Olivermoberg98/LED-Coaster/Software/LED_coaster/tools/rundown/runs/2026-10-10.png

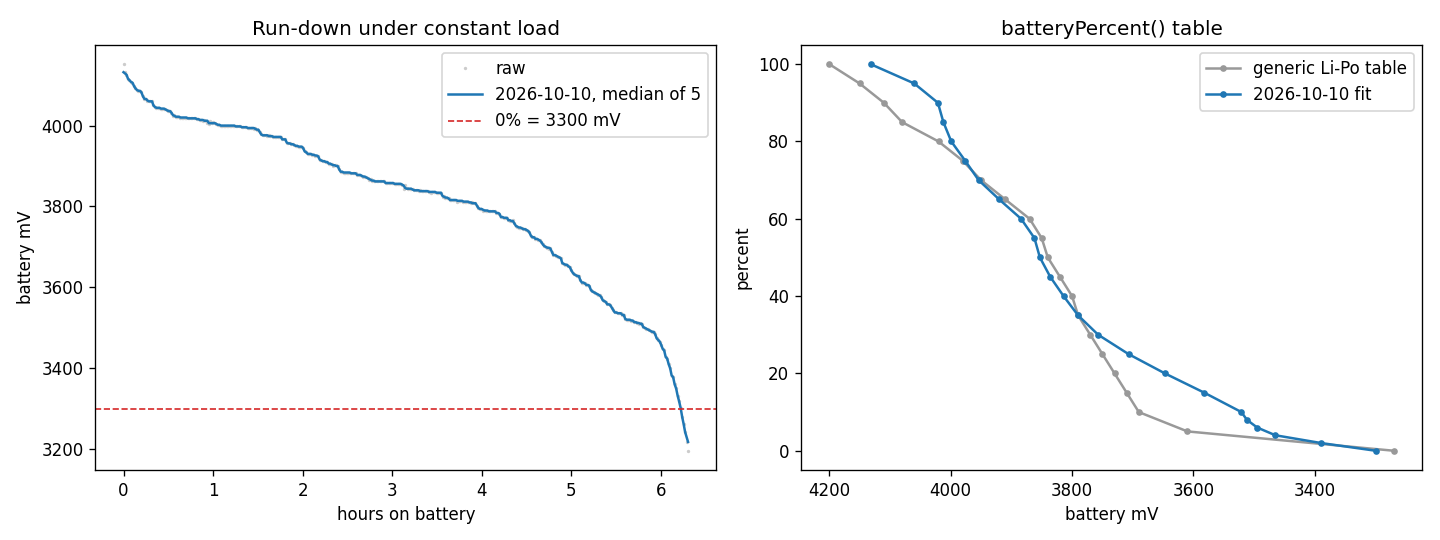
Software/LED_coaster/tools/rundown/runs/2026-10-10.png
