Olivermoberg98/LED-Coaster/Hardware/3d_printing/LED_Coaster_bottom.3mf

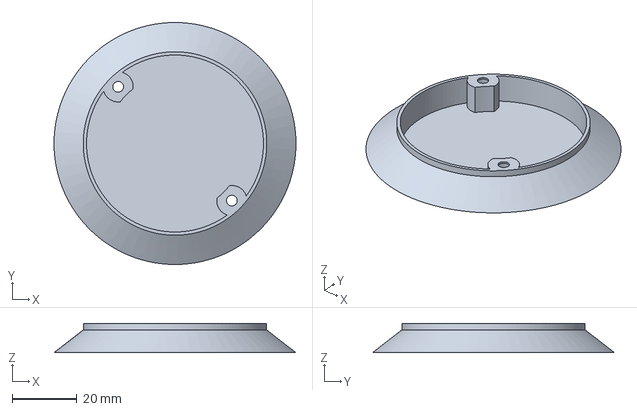
[picture p2: CAD file, 2026-10-16]
Hardware/3d_printing/LED_Coaster_bottom.3mf
74.6 x 74.5 x 9.00 mm
