Olivermoberg98/LED-Coaster/Hardware/3d_printing/LED_Coaster.step

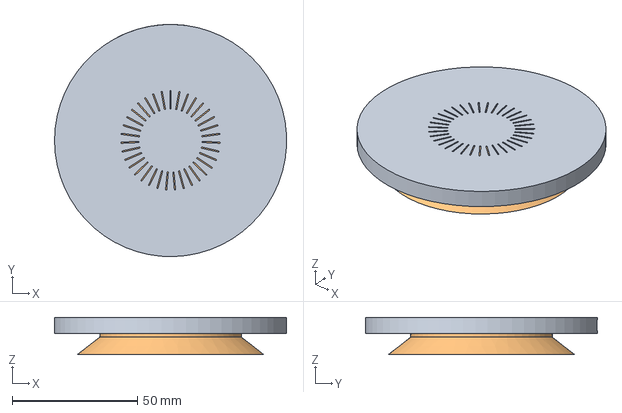
[picture p3: CAD file, 2026-10-16]
Hardware/3d_printing/LED_Coaster.step
92.5 x 92.6 x 14.9 mm
