Olivermoberg98/LED-Coaster/Hardware/3d_printing/LED_Coaster_top.3mf

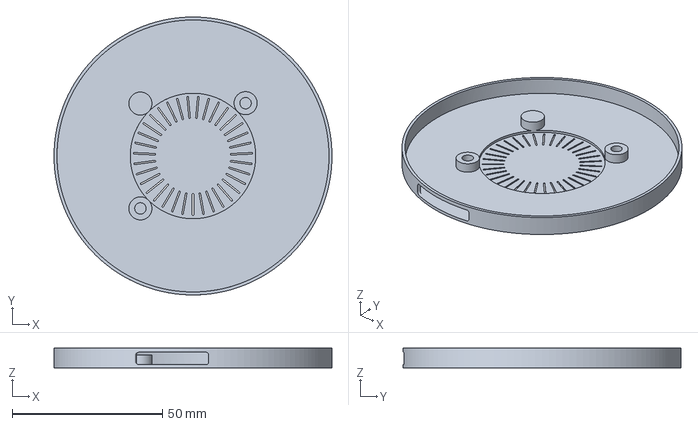
[picture p4: CAD file, 2026-10-16]
Hardware/3d_printing/LED_Coaster_top.3mf
92.6 x 92.6 x 6.50 mm
