Olivermoberg98/LED-Coaster/(list of files, cad)

Other CAD files:
Hardware/3d_printing/LED_Coaster_bottom.stl
Hardware/3d_printing/LED_Coaster_top.stl
