Olivermoberg98/LED-Coaster/Hardware/PCB/LED_Coaster.kicad_pcb

## KiCad design Hardware/PCB/LED_Coaster.kicad_pcb (2026-09-19)

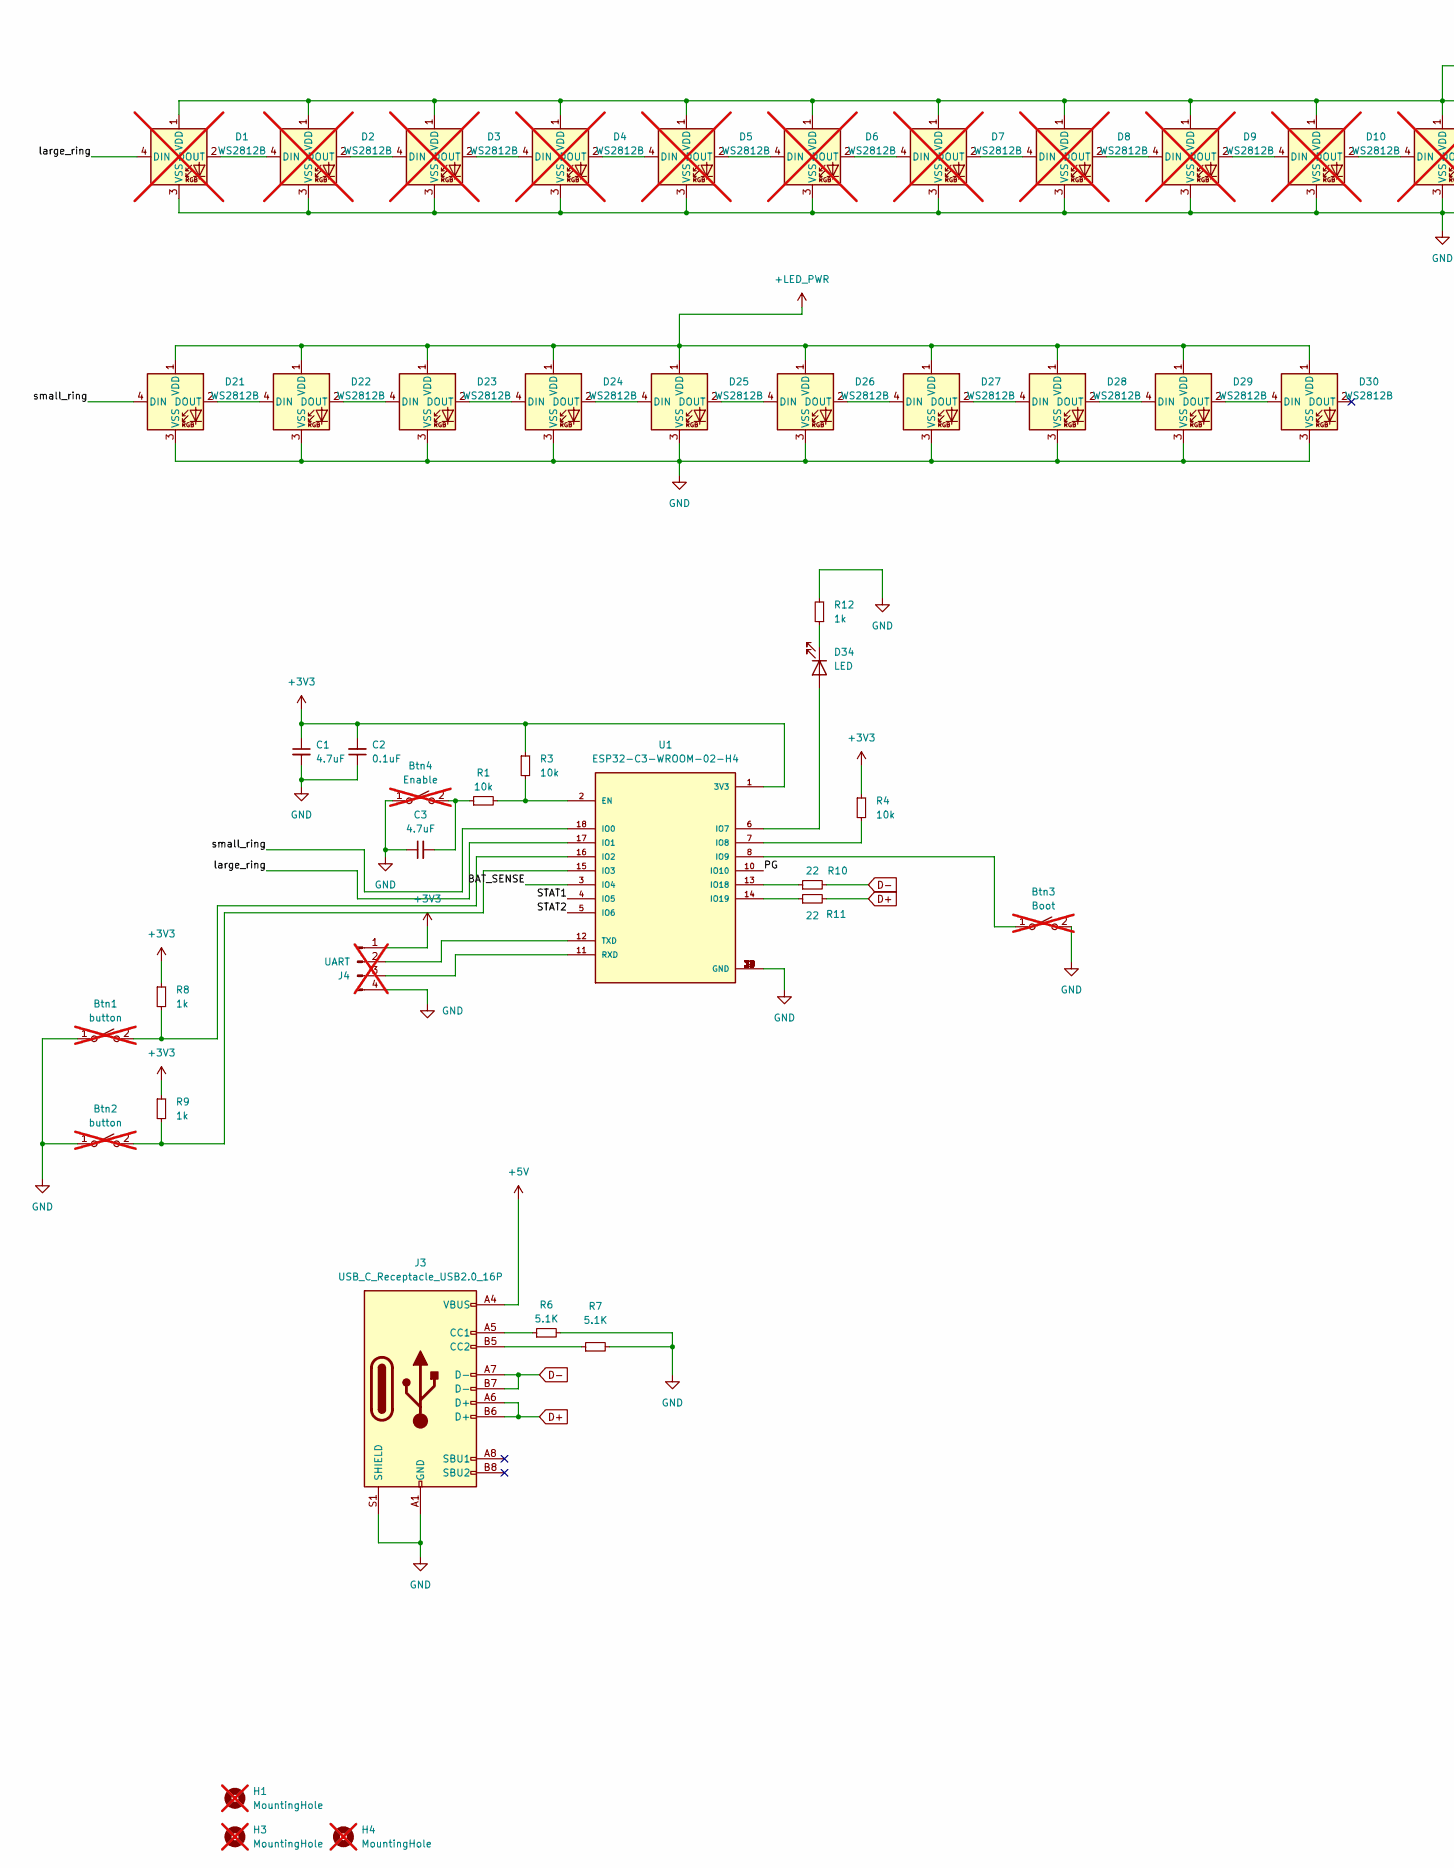
[picture p5: schematic LED_Coaster.kicad_sch, part in row 1, column 1]

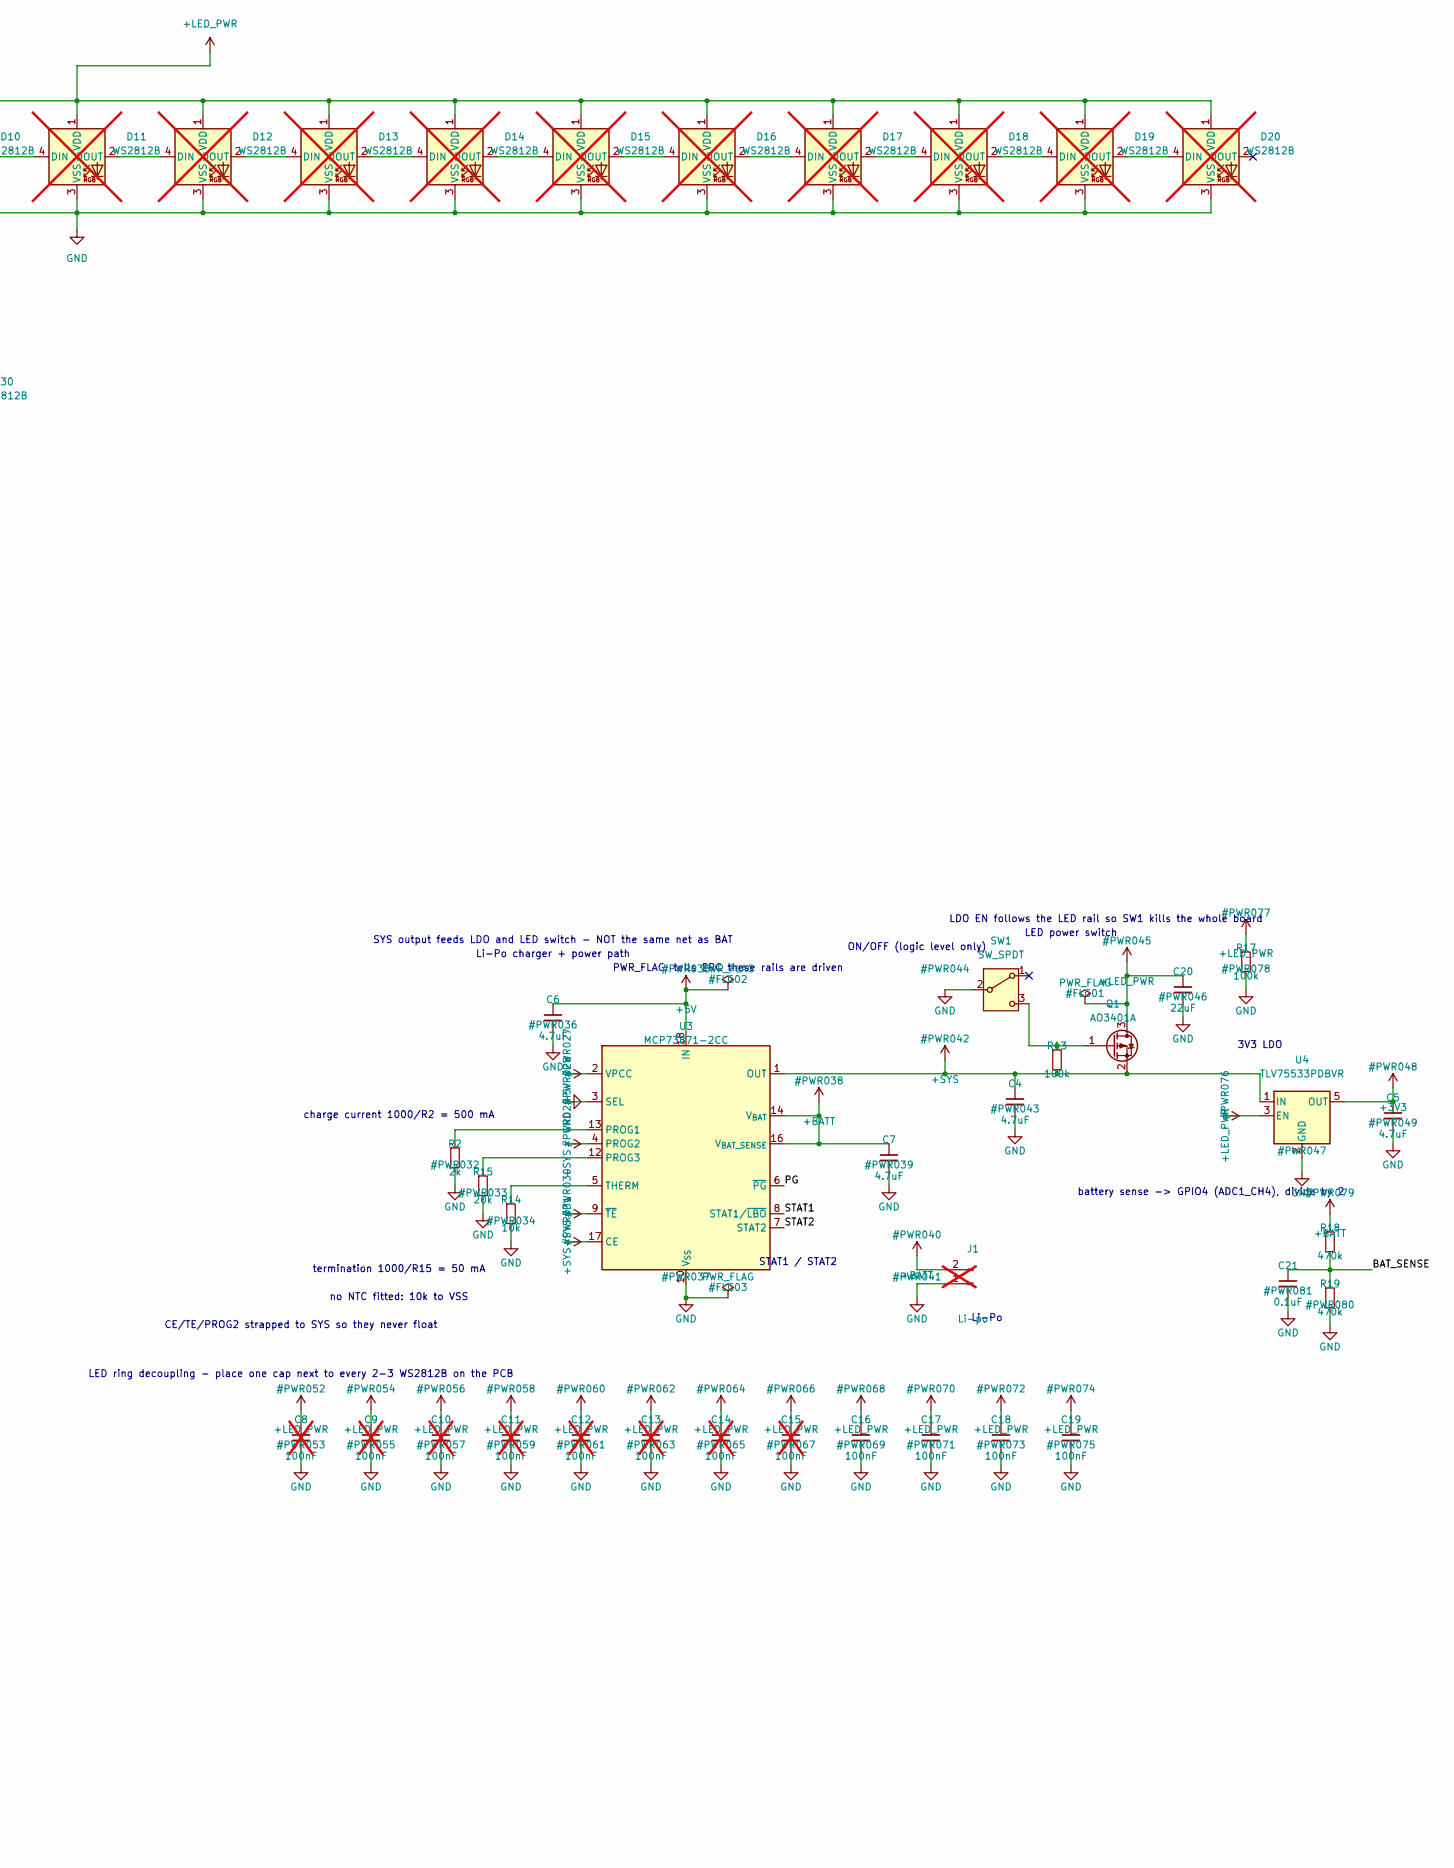
[picture p6: schematic LED_Coaster.kicad_sch, part in row 1, column 2]

Parts:
Btn1, Btn2: button; SW_SPST_SKQG_WithStem; MPN C318884; not fitted
Btn3: Boot; SW_SPST_SKQG_WithStem; MPN C318884; not fitted
Btn4: Enable; SW_SPST_SKQG_WithStem; MPN C318884; not fitted
C1, C3, C4, C5, C6, C7: 4.7uF; C_0805_2012Metric_Pad1.18x1.45mm_HandSolder; MPN C1779
C2, C21: 0.1uF; C_0805_2012Metric_Pad1.18x1.45mm_HandSolder; MPN C28233
C8, C9, C10, C11, C12, C13, C14, C15: 100nF; C_0603_1608Metric_Pad1.08x0.95mm_HandSolder; MPN C14663; not fitted
C16, C17, C18, C19: 100nF; C_0603_1608Metric_Pad1.08x0.95mm_HandSolder; MPN C14663
C20: 22uF; C_0805_2012Metric_Pad1.18x1.45mm_HandSolder; MPN C380336
D1, D2, D3, D4, D5, D6, D7, D8, D9, D10, D11, D12, D13, D14, D15, D16, D17, D18, D19, D20: WS2812B; LED_WS2812_5050_handsolder; MPN C26167850; not fitted
D21, D22, D23, D24, D25, D26, D27, D28, D29, D30: WS2812B; LED_WS2812_5050_handsolder; MPN C26167850
D34: LED; LED_0805_2012Metric_Pad1.15x1.40mm_HandSolder; MPN C2297
H1, H3, H4: MountingHole; MountingHole_4.3mm_M4_Pad_Via; not fitted
J1: Li-po; JST_EH_S2B-EH_1x02_P2.50mm_Horizontal; not fitted
J3: USB_C_Receptacle_USB2.0_16P; USB_C_Receptacle_HRO_TYPE-C-31-M-12; MPN C165948
J4: UART; PinHeader_1x04_P2.54mm_Vertical; not fitted
Q1: AO3401A; SOT-23; MPN C15127
R1, R3, R4, R14: 10k; R_0805_2012Metric_Pad1.20x1.40mm_HandSolder; MPN C17414
R2: 2k; R_0805_2012Metric_Pad1.20x1.40mm_HandSolder; MPN C17604
R6, R7: 5.1K; R_0805_2012Metric_Pad1.20x1.40mm_HandSolder; MPN C27834
R8, R9, R12: 1k; R_0805_2012Metric_Pad1.20x1.40mm_HandSolder; MPN C17513
R10, R11: 22; R_0805_2012Metric_Pad1.20x1.40mm_HandSolder; MPN C17561
R13, R17: 100k; R_0805_2012Metric_Pad1.20x1.40mm_HandSolder; MPN C149504
R15: 20k; R_0805_2012Metric_Pad1.20x1.40mm_HandSolder; MPN C4328
R18, R19: 470k; R_0805_2012Metric_Pad1.20x1.40mm_HandSolder; MPN C17709
SW1: SW_SPDT; SW_SPDT_CK_JS102011SAQN; MPN C221660
U1: ESP32-C3-WROOM-02-H4; MODULE_ESP32-C3-WROOM-02-H4; MPN C2944070
U3: MCP73871-2CC; QFN-20-1EP_4x4mm_P0.5mm_EP2.5x2.5mm_ThermalVias; MPN C5121473
U4: TLV75533PDBVR; SOT-23-5; MPN C404027

Connections:
+3V3: C1.1, C2.2, C5.1, J4.1, R3.1, R4.1, R8.1, R9.1, U1.1 (3V3), U4.5 (OUT)
+5V: C6.1, J3.A4 (VBUS), J3.A9 (VBUS), J3.B4 (VBUS), J3.B9 (VBUS), U3.2 (VPCC), U3.18 (IN), U3.19 (IN)
+BATT: C7.1, J1.2, R18.1, U3.14 (V_{BAT}), U3.15 (V_{BAT}), U3.16 (V_{BAT_SENSE})
+LED_PWR: C8.1, C9.1, C10.1, C11.1, C12.1, C13.1, C14.1, C15.1, C16.1, C17.1, C18.1, C19.1, C20.1, D1.1 (VDD), D2.1 (VDD), D3.1 (VDD), D4.1 (VDD), D5.1 (VDD), D6.1 (VDD), D7.1 (VDD), D8.1 (VDD), D9.1 (VDD), D10.1 (VDD), D11.1 (VDD), D12.1 (VDD), D13.1 (VDD), D14.1 (VDD), D15.1 (VDD), D16.1 (VDD), D17.1 (VDD), D18.1 (VDD), D19.1 (VDD), D20.1 (VDD), D21.1 (VDD), D22.1 (VDD), D23.1 (VDD), D24.1 (VDD), D25.1 (VDD), D26.1 (VDD), D27.1 (VDD), D28.1 (VDD), D29.1 (VDD), D30.1 (VDD), Q1.3 (D), R17.1, U4.3 (EN)
+SYS: C4.1, Q1.2 (S), R13.2, U3.1 (OUT), U3.4 (PROG2), U3.9 (~TE), U3.17 (CE), U3.20 (OUT), U4.1 (IN)
/BAT_SENSE: C21.1, R18.2, R19.1, U1.3 (IO4)
/PG: U1.10 (IO10), U3.6 (~PG)
/STAT1: U1.4 (IO5), U3.8 (STAT1/~LBO)
/STAT2: U1.5 (IO6), U3.7 (STAT2)
/large_ring: D1.4 (DIN), U1.17 (IO1)
/small_ring: D21.4 (DIN), U1.18 (IO0)
D+: J3.A6 (D+), J3.B6 (D+), R11.2
D-: J3.A7 (D-), J3.B7 (D-), R10.2
GND: Btn1.1 (A), Btn2.1 (A), Btn3.2 (B), Btn4.1 (A), C1.2, C2.1, C3.1, C4.2, C5.2, C6.2, C7.2, C8.2, C9.2, C10.2, C11.2, C12.2, C13.2, C14.2, C15.2, C16.2, C17.2, C18.2, C19.2, C20.2, C21.2, D1.3 (VSS), D2.3 (VSS), D3.3 (VSS), D4.3 (VSS), D5.3 (VSS), D6.3 (VSS), D7.3 (VSS), D8.3 (VSS), D9.3 (VSS), D10.3 (VSS), D11.3 (VSS), D12.3 (VSS), D13.3 (VSS), D14.3 (VSS), D15.3 (VSS), D16.3 (VSS), D17.3 (VSS), D18.3 (VSS), D19.3 (VSS), D20.3 (VSS), D21.3 (VSS), D22.3 (VSS), D23.3 (VSS), D24.3 (VSS), D25.3 (VSS), D26.3 (VSS), D27.3 (VSS), D28.3 (VSS), D29.3 (VSS), D30.3 (VSS), J1.1, J3.A1 (GND), J3.A12 (GND), J3.B1 (GND), J3.B12 (GND), J3.S1 (SHIELD), J4.4, R2.2, R6.2, R7.2, R12.2, R14.2, R15.2, R17.2, R19.2, SW1.2 (B), U1.9 (GND), U1.19 (GND), U1.20 (GND), U1.21 (GND), U1.22 (GND), U1.23 (GND), U1.24 (GND), U1.25 (GND), U1.26 (GND), U1.27 (GND), U1.28 (GND), U1.29 (GND), U1.30 (GND), U1.31 (GND), U1.32 (GND), U1.33 (GND), U1.34 (GND), U1.35 (GND), U1.36 (GND), U1.37 (GND), U1.38 (GND), U1.39 (GND), U3.3 (SEL), U3.10 (V_{SS}), U3.11 (V_{SS}), U3.21 (V_{SS}), U4.2 (GND)
unnamed: Btn1.2 (B), R8.2, U1.16 (IO2)
unnamed: Btn2.2 (B), R9.2, U1.15 (IO3)
unnamed: Btn3.1 (A), U1.8 (IO9)
unnamed: Btn4.2 (B), C3.2, R1.1
unnamed: D1.2 (DOUT), D2.4 (DIN)
unnamed: D2.2 (DOUT), D3.4 (DIN)
unnamed: D3.2 (DOUT), D4.4 (DIN)
unnamed: D4.2 (DOUT), D5.4 (DIN)
unnamed: D5.2 (DOUT), D6.4 (DIN)
unnamed: D6.2 (DOUT), D7.4 (DIN)
unnamed: D7.2 (DOUT), D8.4 (DIN)
unnamed: D8.2 (DOUT), D9.4 (DIN)
unnamed: D9.2 (DOUT), D10.4 (DIN)
unnamed: D10.2 (DOUT), D11.4 (DIN)
unnamed: D11.2 (DOUT), D12.4 (DIN)
unnamed: D12.2 (DOUT), D13.4 (DIN)
unnamed: D13.2 (DOUT), D14.4 (DIN)
unnamed: D14.2 (DOUT), D15.4 (DIN)
unnamed: D15.2 (DOUT), D16.4 (DIN)
unnamed: D16.2 (DOUT), D17.4 (DIN)
unnamed: D17.2 (DOUT), D18.4 (DIN)
unnamed: D18.2 (DOUT), D19.4 (DIN)
unnamed: D19.2 (DOUT), D20.4 (DIN)
unnamed: D21.2 (DOUT), D22.4 (DIN)
unnamed: D22.2 (DOUT), D23.4 (DIN)
unnamed: D23.2 (DOUT), D24.4 (DIN)
unnamed: D24.2 (DOUT), D25.4 (DIN)
unnamed: D25.2 (DOUT), D26.4 (DIN)
unnamed: D26.2 (DOUT), D27.4 (DIN)
unnamed: D27.2 (DOUT), D28.4 (DIN)
unnamed: D28.2 (DOUT), D29.4 (DIN)
unnamed: D29.2 (DOUT), D30.4 (DIN)
unnamed: D34.2 (A), U1.6 (IO7)
unnamed: D34.1 (K), R12.1
unnamed: J3.A5 (CC1), R6.1
unnamed: J3.B5 (CC2), R7.1
unnamed: J4.2, U1.12 (TXD)
unnamed: J4.3, U1.11 (RXD)
unnamed: Q1.1 (G), R13.1, SW1.3 (C)
unnamed: R1.2, R3.2, U1.2 (EN)
unnamed: R4.2, U1.7 (IO8)
unnamed: R10.1, U1.13 (IO18)
unnamed: R11.1, U1.14 (IO19)
unnamed: R2.1, U3.13 (PROG1)
unnamed: R15.1, U3.12 (PROG3)
unnamed: R14.1, U3.5 (THERM)

Notes on the sheet:
Li-Po charger + power path
SYS output feeds LDO and LED switch - NOT the same net as BAT
charge current 1000/R2 = 500 mA
termination 1000/R15 = 50 mA
no NTC fitted: 10k to VSS
CE/TE/PROG2 strapped to SYS so they never float
ON/OFF (logic level only)
LED power switch
3V3 LDO
Li-Po
STAT1 / STAT2
LED ring decoupling - place one cap next to every 2-3 WS2812B on the PCB
LDO EN follows the LED rail so SW1 kills the whole board
battery sense -> GPIO4 (ADC1_CH4), divide by 2
PWR_FLAG: tells ERC these rails are driven

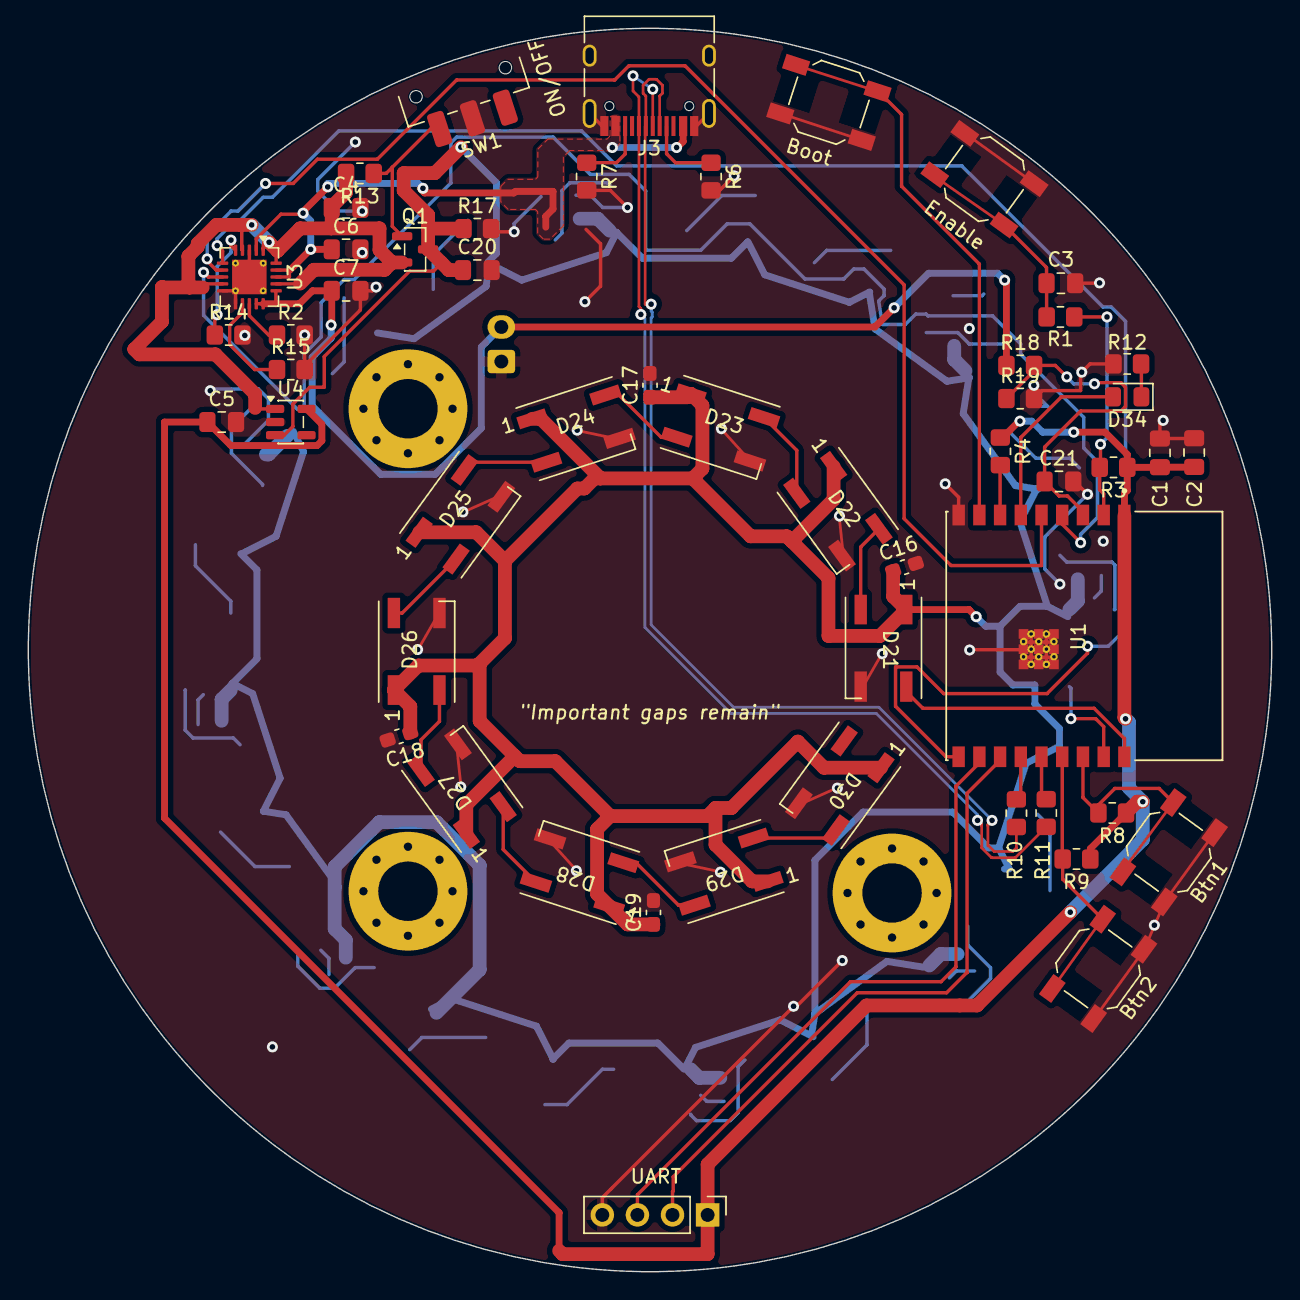
[picture p7: board LED_Coaster.kicad_pcb from above]

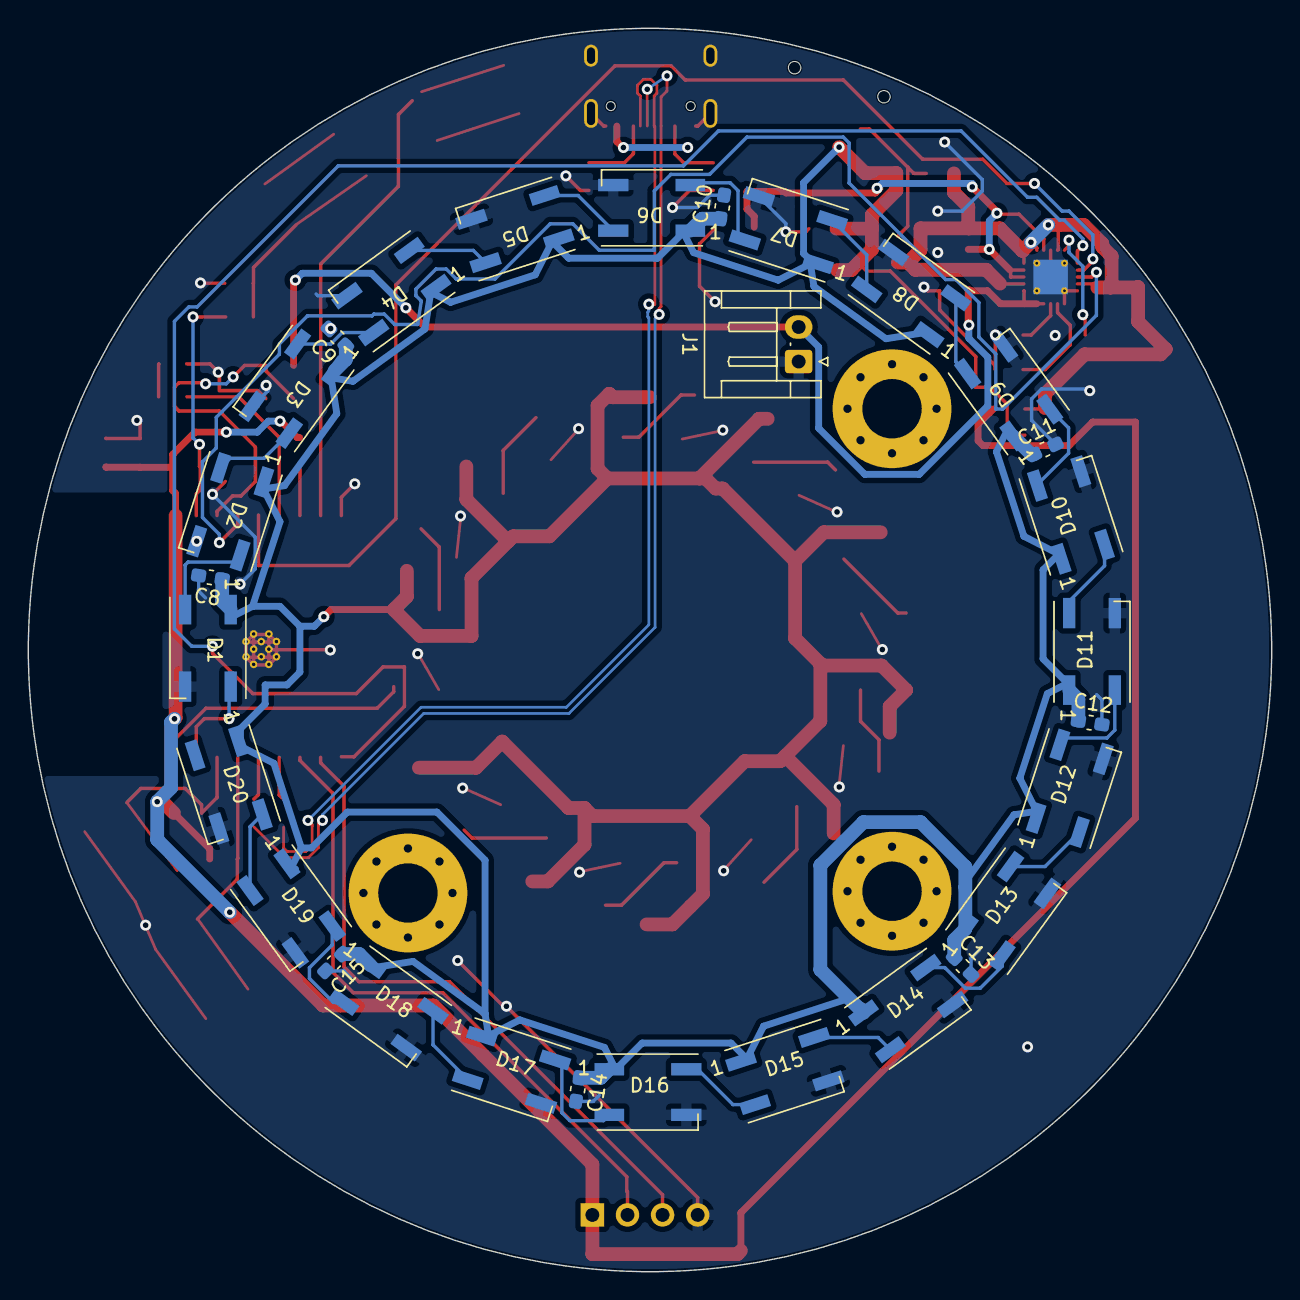
[picture p8: board LED_Coaster.kicad_pcb from below]

Board: 2 copper layers, 90.0 x 90.0 mm, 84 parts (29 on the bottom side), 60 nets.
