Olivermoberg98/LED-Coaster/Software/LED_coaster/src/main.cpp

#include <Arduino.h>
#include <FastLED.h>
#include <patterns.h>
#include <BLEHandler.h>
#ifdef RUNDOWN_LOG
#include <LittleFS.h>
#endif

CRGB led_output_inner[NUM_LEDS_INNER]; 
CRGB led_output_outer[NUM_LEDS_OUTER]; 

PatternType inner_pattern = FIXED;
PatternType outer_pattern = FIXED;

std::string coasterID = "05"; // Unique per coaster: advertised as "Coaster-<id>"
BLEHandler blehandler(coasterID);

// Battery sense: +BATT through a 470k/470k divider, so the pin sees half the cell.
const int BAT_SENSE_PIN = 4;
// MCP73871 status outputs, all open-drain (High-Z reads HIGH with the pull-ups).
const int STAT1_PIN = 5;
const int STAT2_PIN = 6;
const int PG_PIN = 10;
// D34, through R12 (1k) to GND: the board's only charge indicator.
const int CHARGE_LED_PIN = 7;
const unsigned long BATTERY_REPORT_INTERVAL_MS = 2000;
unsigned long lastBatteryReport = 0;
const unsigned long STATUS_PUSH_INTERVAL_MS = 30000;
unsigned long lastStatusPush = 0;
// Below this the low-battery flag is set even before the charger raises LBO (3.1 V).
// About 15% on the fitted curve, roughly 55 minutes left at a ~150 mA load.
const uint32_t LOW_BATTERY_WARN_MV = 3580;
// Below this on battery for three readings in a row, the coaster turns its LEDs off
// and deep-sleeps (0% on the fitted curve). SW1 off/on wakes it.
const uint32_t CUTOFF_MV = 3300;
int cutoffLowReadings = 0;
// While charging, the ~420 mA charge current through the ~0.24 Ohm path to the cell
// lifts the reading about this far above the discharge curve.
const uint32_t CHARGING_OFFSET_MV = 100;
// LED current cap: the full cap down to 3.60 V, where it still holds +SYS at 3.40 V,
// then falling linearly to the minimum at 3.40 V as the cell's sag grows.
const uint32_t LED_CAP_FULL_MV = 3600;
const uint32_t LED_CAP_MIN_MV = 3400;
const uint32_t LED_CAP_FULL_MA = 900;
const uint32_t LED_CAP_MIN_MA = 300;
// The cap changes only after the reading moves this far, so brightness doesn't step visibly.
const uint32_t LED_CAP_HYSTERESIS_MV = 50;
uint32_t ledCapMilliamps = LED_CAP_FULL_MA;
uint32_t ledCapMillivolts = 0;

// Charger state as carried in Package 3; values are part of the BLE contract.
enum ChargerState : uint8_t {
  CHARGER_UNKNOWN = 0,
  CHARGER_ON_BATTERY = 1,
  CHARGER_CHARGING = 2,
  CHARGER_COMPLETE = 3,
  CHARGER_LOW_BATTERY = 4,
  CHARGER_TEMP_FAULT = 5,
  CHARGER_NO_BATTERY = 6
};
// Reported state only changes once a new reading has held for two reads in a row.
ChargerState reportedChargerState = CHARGER_UNKNOWN;
ChargerState pendingChargerState = CHARGER_UNKNOWN;

// Averages several calibrated readings; the LED rail is noisy while patterns run.
uint32_t readBatteryMillivolts() {
  const int samples = 16;
  uint32_t sum = 0;
  for (int i = 0; i < samples; i++) {
    sum += analogReadMilliVolts(BAT_SENSE_PIN);
  }
  return (sum / samples) * 2;
}

// Discharge curve of the 1500 mAh cell, fitted from the 2026-10-10 run-down at a
// constant ~150 mA load, linearly interpolated between points. 0% sits at 3.30 V.
int batteryPercent(uint32_t mv) {
  static const uint16_t curve[][2] = {
    {4132, 100}, {4060, 95}, {4021, 90}, {4012, 85}, {3999, 80}, {3976, 75},
    {3954, 70},  {3920, 65}, {3884, 60}, {3862, 55}, {3853, 50}, {3836, 45},
    {3814, 40},  {3790, 35}, {3757, 30}, {3707, 25}, {3647, 20}, {3582, 15},
    {3521, 10},  {3512, 8},  {3495, 6},  {3465, 4},  {3390, 2},  {3300, 0}
  };
  const int points = sizeof(curve) / sizeof(curve[0]);
  if (mv >= curve[0][0]) return 100;
  if (mv <= curve[points - 1][0]) return 0;
  for (int i = 1; i < points; i++) {
    if (mv >= curve[i][0]) {
      uint32_t vHigh = curve[i - 1][0], vLow = curve[i][0];
      uint32_t pHigh = curve[i - 1][1], pLow = curve[i][1];
      return pLow + (mv - vLow) * (pHigh - pLow) / (vHigh - vLow);
    }
  }
  return 0;
}

// Decodes the status outputs per MCP73871 datasheet Table 5-1.
ChargerState chargerState() {
  bool pg = digitalRead(PG_PIN);
  bool stat1 = digitalRead(STAT1_PIN);
  bool stat2 = digitalRead(STAT2_PIN);
  if (!pg && !stat1 && stat2)  return CHARGER_CHARGING;
  if (!pg && stat1 && !stat2)  return CHARGER_COMPLETE;
  if (!pg && !stat1 && !stat2) return CHARGER_TEMP_FAULT;
  if (!pg && stat1 && stat2)   return CHARGER_NO_BATTERY;
  if (pg && !stat1 && stat2)   return CHARGER_LOW_BATTERY;
  if (pg && stat1 && stat2)    return CHARGER_ON_BATTERY;
  return CHARGER_UNKNOWN;
}

const char* chargerStateName(ChargerState state) {
  switch (state) {
    case CHARGER_ON_BATTERY:  return "on battery";
    case CHARGER_CHARGING:    return "charging";
    case CHARGER_COMPLETE:    return "charge complete";
    case CHARGER_LOW_BATTERY: return "low battery";
    case CHARGER_TEMP_FAULT:  return "temperature fault";
    case CHARGER_NO_BATTERY:  return "no battery present";
    default:                  return "unknown";
  }
}

#ifdef RUNDOWN_LOG
// Run-down log: one sample per minute while on battery, appended to flash so it
// survives the end of the run. Read back over USB serial with "dump", wiped with "clear".
const char* RUNDOWN_FILE = "/rundown.bin";
const unsigned long RUNDOWN_SAMPLE_INTERVAL_MS = 60000;
// The run ends below this, before the cell's own protection trips.
const uint32_t RUNDOWN_CUTOFF_MV = 3200;
const uint8_t RUNDOWN_CUTOFF_FLAG = 0x80;
// Constant inner-ring load of about 120 mA, so a 1500 mAh cell runs down overnight.
const CRGB RUNDOWN_LOAD_COLOR = CRGB(85, 85, 85);
unsigned long lastRundownSample = 0;
bool rundownSampled = false;
int rundownLowReadings = 0;

struct __attribute__((packed)) RundownSample {
  uint32_t uptime;
  uint16_t mv;
  uint8_t chargerState;
  uint8_t flags;
};

void appendRundownSample(uint32_t mv, uint8_t state, uint8_t flags) {
  RundownSample sample = {millis() / 1000, (uint16_t)mv, state, flags};
  File file = LittleFS.open(RUNDOWN_FILE, FILE_APPEND);
  if (file) {
    file.write((const uint8_t*)&sample, sizeof(sample));
    file.close();
  }
}

// Called on every battery reading. Samples once a minute while on battery, and at
// the cut-off writes a final flagged sample, turns the LEDs off and deep-sleeps.
void rundownReading(uint32_t mv, uint8_t state, uint8_t flags, bool usbPower) {
  if (usbPower) {
    rundownLowReadings = 0;
    return;
  }
  rundownLowReadings = (mv < RUNDOWN_CUTOFF_MV) ? rundownLowReadings + 1 : 0;
  if (rundownLowReadings >= 3) {
    appendRundownSample(mv, state, flags | RUNDOWN_CUTOFF_FLAG);
    FastLED.clear(true);
    Serial.println("Run-down: cut-off reached, entering deep sleep");
    esp_deep_sleep_start();
  }
  if (!rundownSampled || millis() - lastRundownSample >= RUNDOWN_SAMPLE_INTERVAL_MS) {
    rundownSampled = true;
    lastRundownSample = millis();
    appendRundownSample(mv, state, flags);
  }
}

void handleRundownCommand() {
  if (!Serial.available()) return;
  String command = Serial.readStringUntil('\n');
  command.trim();
  if (command == "dump") {
    Serial.println("uptime_s,mv,charger_state,flags");
    File file = LittleFS.open(RUNDOWN_FILE, FILE_READ);
    RundownSample sample;
    while (file && file.read((uint8_t*)&sample, sizeof(sample)) == sizeof(sample)) {
      Serial.printf("%u,%u,%u,%u\n", sample.uptime, sample.mv, sample.chargerState, sample.flags);
    }
    if (file) file.close();
    Serial.println("end");
  } else if (command == "clear") {
    LittleFS.remove(RUNDOWN_FILE);
    Serial.println("Run-down log cleared");
  }
}
#endif

uint32_t ledCapForMillivolts(uint32_t mv) {
  if (mv >= LED_CAP_FULL_MV) return LED_CAP_FULL_MA;
  if (mv <= LED_CAP_MIN_MV) return LED_CAP_MIN_MA;
  return LED_CAP_MIN_MA + (mv - LED_CAP_MIN_MV) * (LED_CAP_FULL_MA - LED_CAP_MIN_MA) /
                          (LED_CAP_FULL_MV - LED_CAP_MIN_MV);
}

// Scales the LED current cap with the cell voltage. Rings are re-rendered so a
// static FIXED frame picks up the new cap.
void updateLedCap(uint32_t mv) {
  uint32_t cap = ledCapForMillivolts(mv);
  if (cap == ledCapMilliamps) return;
  bool moved = mv + LED_CAP_HYSTERESIS_MV <= ledCapMillivolts ||
               mv >= ledCapMillivolts + LED_CAP_HYSTERESIS_MV;
  if (!moved && cap != LED_CAP_FULL_MA && cap != LED_CAP_MIN_MA) return;
  ledCapMilliamps = cap;
  ledCapMillivolts = mv;
  FastLED.setMaxPowerInVoltsAndMilliamps(5, cap);
  inner_needs_update = true;
  outer_needs_update = true;
  Serial.printf("LED current cap: %u mA\n", cap);
}

// Shows the reported charger state on D34: on while charging, slow blink when
// complete, fast blink on a fault, off on battery so it costs nothing there.
void updateChargeLed() {
  bool on;
  switch (reportedChargerState) {
    case CHARGER_CHARGING:   on = true; break;
    case CHARGER_COMPLETE:   on = (millis() / 1000) % 2 == 0; break;
    case CHARGER_TEMP_FAULT:
    case CHARGER_NO_BATTERY: on = (millis() / 100) % 2 == 0; break;
    default:                 on = false; break;
  }
  digitalWrite(CHARGE_LED_PIN, on ? HIGH : LOW);
}

// Ends use on an empty cell: a last status to the app, LEDs off, deep sleep.
void checkCutoff(uint32_t mv, bool usbPower) {
  cutoffLowReadings = (!usbPower && mv < CUTOFF_MV) ? cutoffLowReadings + 1 : 0;
  if (cutoffLowReadings < 3) return;
  blehandler.notifyStatus();
  delay(100);
  FastLED.clear(true);
  Serial.println("Battery empty: LEDs off, entering deep sleep");
  esp_deep_sleep_start();
}

// Reads the battery and charger, logs them, and loads Package 3 into the status
// characteristics. Returns true when the reported charger state changed.
bool updateBatteryStatus() {
  uint8_t pins = digitalRead(PG_PIN) | (digitalRead(STAT1_PIN) << 1) | (digitalRead(STAT2_PIN) << 2);
#ifdef BATTERY_STATUS_FAKE
  // Steps through every charger state and a falling voltage, one step per 5 s.
  uint32_t step = millis() / 5000;
  ChargerState state = (ChargerState)(step % 7);
  uint32_t mv = 4200 - (step % 20) * 50;
  bool usbPower = state == CHARGER_CHARGING || state == CHARGER_COMPLETE ||
                  state == CHARGER_TEMP_FAULT || state == CHARGER_NO_BATTERY;
#else
  ChargerState state = chargerState();
  uint32_t mv = readBatteryMillivolts();
  bool usbPower = !(pins & 0x01);
#endif

  bool changed = false;
  if (state != reportedChargerState && state == pendingChargerState) {
    reportedChargerState = state;
    changed = true;
  }
  pendingChargerState = state;

  // While charging, the discharge curve read CHARGING_OFFSET_MV lower tracks the charge
  // actually delivered to within a few points; 100% waits for the charger to terminate.
  uint8_t percent;
  if (reportedChargerState == CHARGER_COMPLETE) {
    percent = 100;
  } else if (reportedChargerState == CHARGER_CHARGING) {
    int charging = batteryPercent(mv > CHARGING_OFFSET_MV ? mv - CHARGING_OFFSET_MV : 0);
    percent = charging > 99 ? 99 : charging;
  } else {
    percent = batteryPercent(mv);
  }
  uint8_t flags = 0;
  if (reportedChargerState == CHARGER_LOW_BATTERY || mv < LOW_BATTERY_WARN_MV) flags |= 0x01;
  if (usbPower) flags |= 0x02;
#ifdef BATTERY_STATUS_FAKE
  flags |= 0x04;
#endif
  uint32_t uptime = millis() / 1000;

  // Package 3: see "The BLE contract" in CLAUDE.md
  uint8_t package3[13] = {
    0x03, 0x01,
    (uint8_t)(mv & 0xFF), (uint8_t)(mv >> 8),
    percent, reportedChargerState, flags, pins,
    (uint8_t)(uptime & 0xFF), (uint8_t)(uptime >> 8), (uint8_t)(uptime >> 16), (uint8_t)(uptime >> 24),
    0
  };
  for (int i = 0; i < 12; i++) package3[12] += package3[i];
  blehandler.setStatus(package3, sizeof(package3), percent);

  Serial.printf("Battery: %u mV, %d%%, charger: %s (PG=%d STAT1=%d STAT2=%d)\n",
                mv, percent, chargerStateName(state),
                pins & 0x01, (pins >> 1) & 0x01, (pins >> 2) & 0x01);
#ifdef RUNDOWN_LOG
  // The run-down build has its own lower stop, so it records past 0%.
  rundownReading(mv, reportedChargerState, flags, usbPower);
#elif !defined(BATTERY_STATUS_FAKE)
  checkCutoff(mv, usbPower);
#endif
#ifndef BATTERY_STATUS_FAKE
  updateLedCap(mv);
#endif
  return changed;
}

void setup() {
  // Setup for the LEDs
  FastLED.addLeds<WS2812, LED_PIN_INNER, GRB>(led_output_inner, NUM_LEDS_INNER);
  FastLED.addLeds<WS2812, LED_PIN_OUTER, GRB>(led_output_outer, NUM_LEDS_OUTER);

  // All 30 TZ-5050S2RGB at full white draw 1.08 A (12 mA per channel), and the
  // ~265 mOhm from the cell through the charger's BAT->SYS path and Q1 would
  // then sag +SYS below the LDO's dropout on a half-empty battery, resetting the
  // ESP32. 900 mA holds +SYS at 3.40 V down to a 3.6 V cell; updateLedCap()
  // lowers the cap below that.
  FastLED.setMaxPowerInVoltsAndMilliamps(5, LED_CAP_FULL_MA);

  // Setup for the LED colors
  updateLEDColors(0, NUM_LEDS_INNER);
  updateLEDColors(1, NUM_LEDS_OUTER);

  Serial.begin(9600);

  analogSetPinAttenuation(BAT_SENSE_PIN, ADC_11db);
  pinMode(STAT1_PIN, INPUT_PULLUP);
  pinMode(STAT2_PIN, INPUT_PULLUP);
  pinMode(PG_PIN, INPUT_PULLUP);
  pinMode(CHARGE_LED_PIN, OUTPUT);
  digitalWrite(CHARGE_LED_PIN, LOW);

  // Setup Bluetooth
  blehandler.begin();

#ifdef RUNDOWN_LOG
  LittleFS.begin(true);
  fill_solid(led_output_inner, NUM_LEDS_INNER, RUNDOWN_LOAD_COLOR);
  FastLED.show();
#endif

  // Starts the charger state settled, so the first push is not "unknown"
  reportedChargerState = pendingChargerState = chargerState();
  updateBatteryStatus();
  lastBatteryReport = millis();
}

void loop() {
  // Update connection state machine
  blehandler.updateConnectionState();
  blehandler.updateAdvertising();
#ifdef RUNDOWN_LOG
  handleRundownCommand();
#endif

  bool pushStatus = false;
  if (millis() - lastBatteryReport >= BATTERY_REPORT_INTERVAL_MS) {
    lastBatteryReport = millis();
    pushStatus = updateBatteryStatus();
  }
  updateChargeLed();
  if (blehandler.statusSubscribePending) {
    blehandler.statusSubscribePending = false;
    pushStatus = true;
  }
  if (blehandler.isConnected() && millis() - lastStatusPush >= STATUS_PUSH_INTERVAL_MS) {
    pushStatus = true;
  }
  if (pushStatus) {
    blehandler.notifyStatus();
    lastStatusPush = millis();
  }

  // Only process patterns when fully connected
  if (blehandler.shouldProcessPatterns()) {
    // Inner ring
    if (blehandler.innerChecked && blehandler.deviceConnected) {
      if (inner_pattern == FIXED && !inner_needs_update) {
        delay(50);
      } else {
        runPattern(inner_pattern, colors_inner, led_output_inner, NUM_LEDS_INNER);
        if (inner_pattern == FIXED) inner_needs_update = false;
      }
    } else {
      clearRing(led_output_inner, NUM_LEDS_INNER);
      inner_needs_update = true;
    }

    // Outer ring
    if (blehandler.outerChecked && blehandler.deviceConnected) {
      if (outer_pattern == FIXED && !outer_needs_update) {
        delay(50);
      } else {
        runPattern(outer_pattern, colors_outer, led_output_outer, NUM_LEDS_OUTER);
        if (outer_pattern == FIXED) outer_needs_update = false;
      }
    } else {
      clearRing(led_output_outer, NUM_LEDS_OUTER);
      outer_needs_update = true;
    }

    // Handle incoming pattern and color data
    if (blehandler.package2Received) {
      inner_pattern = stringToPatternType(blehandler.received_pattern);
      outer_pattern = stringToPatternType(blehandler.received_pattern);

      if (inner_pattern != RAINBOW || outer_pattern != RAINBOW) {
        updateLEDColors(0, NUM_LEDS_INNER, blehandler.received_colors);
        updateLEDColors(1, NUM_LEDS_OUTER, blehandler.received_colors);
      }
      
      inner_needs_update = true;
      outer_needs_update = true;
      
      blehandler.package2Received = false;
    }
  }

  delay(10);
}
