Olivermoberg98/LED-Coaster/Software/LED_coaster/src/patterns.cpp

#include "patterns.h"
#include "Arduino.h"
#include <FastLED.h>

// Define the color arrays
CRGB colors_inner[NUM_LEDS_INNER];
CRGB colors_outer[NUM_LEDS_OUTER];

bool inner_needs_update = true;
bool outer_needs_update = true;

// Rainbow hue, shared by both rings so they stay in step
static uint8_t sharedHue = 0;
static uint16_t sharedCounter = 0;

PatternType stringToPatternType(const std::string& pattern) {
    if (pattern == "FIXED") {
        return FIXED;
    } else if (pattern == "CHASER") {
        return CHASER;
    } else if (pattern == "PULSE") {
        return PULSE;
    } else if (pattern == "RAINBOW") {
        return RAINBOW;
    } else {
        return FIXED;  // Default to FIXED if the pattern is unrecognized
    }
}

void updateLEDColors(int ring, int NUM_LEDS, const int colors[3]) {
    if (ring == 0) {
        for (int i = 0; i < NUM_LEDS; i++) {
            colors_inner[i] = CRGB(colors[0], colors[1], colors[2]);
        }
    } else if (ring == 1) {
        for (int i = 0; i < NUM_LEDS; i++) {
            colors_outer[i] = CRGB(colors[0], colors[1], colors[2]);
        }
    }
    FastLED.show();
}

void updateLEDColors(int ring, int NUM_LEDS) {
    const int defaultColors[3] = {0, 0, 255}; // Default color: Blue
    updateLEDColors(ring, NUM_LEDS, defaultColors);
}

void runPattern(PatternType pattern, CRGB* ledsIn, CRGB* ledsOut, int numberOfLeds) {
    switch (pattern) {
        case FIXED:
            fixed(ledsIn, ledsOut, numberOfLeds);
            break;
        case CHASER:
            chaser(ledsIn, ledsOut, numberOfLeds, 5, 1.0f, 255, 50); 
            break;
        case PULSE:
            pulse(ledsIn, ledsOut, numberOfLeds, 0.1f, 255, 25); 
            break;
        case RAINBOW:
            rainbow(ledsOut, numberOfLeds);
            break;
        default:
            fixed(ledsIn, ledsOut, numberOfLeds);
            break;
    }
}

void fixed(CRGB* ledsIn, CRGB* ledsOut, int numberOfLeds) {
    for (int i = 0; i < numberOfLeds; i++) {
        ledsOut[i] = ledsIn[i];
    }
    FastLED.show();
}

void pulse(CRGB* ledsIn, CRGB* ledsOut, int numberOfLeds, float pulseFrequency, float maxBrightness, float minBrightness) {
    // Calculate the pulse value (between 0 and 1)
    float pulse = (sin((2 * PI * millis() * pulseFrequency) / 1000.0f) + 1.0) / 2.0;

    // Scale brightness between 0 and 1
    float scaledMaxBrightness = maxBrightness / 255.0f;
    float scaledMinBrightness = minBrightness / 255.0f;
    float scaledBrightness = pulse * (scaledMaxBrightness - scaledMinBrightness) + scaledMinBrightness;

    for (int i = 0; i < numberOfLeds; i++) {
        // Scale the original colors to the new brightness
        ledsOut[i].r = constrain(ledsIn[i].r * scaledBrightness, 0, 255);
        ledsOut[i].g = constrain(ledsIn[i].g * scaledBrightness, 0, 255);
        ledsOut[i].b = constrain(ledsIn[i].b * scaledBrightness, 0, 255);
    }
    FastLED.show();
}

void chaser(CRGB* ledsIn, CRGB* ledsOut, int numberOfLeds, int brightSpots, float rotationalFrequency, float maxBrightness, float minBrightness) {
    static unsigned long lastUpdateTime = 0;
    static float rotation = 0;

    unsigned long currentTime = millis();
    unsigned long deltaTime = currentTime - lastUpdateTime;
    
    // Only update rotation once per loop cycle (when lastUpdateTime changes)
    if (deltaTime > 0) {
        rotation += (rotationalFrequency * 360.0f * deltaTime) / 1000.0f;
        if (rotation >= 360.0f) rotation -= 360.0f;
        lastUpdateTime = currentTime;
    }

    int spotWidth = numberOfLeds / brightSpots;

    for (int i = 0; i < numberOfLeds; i++) {
        int rotatedPosition = (i + (int)(rotation * numberOfLeds / 360.0f)) % numberOfLeds;
        
        // Original logic: is this position in the first spotWidth positions?
        bool isBrightSpot = (rotatedPosition < spotWidth);

        // Scale brightness
        uint8_t brightness = isBrightSpot ? maxBrightness : minBrightness;

        ledsOut[i].r = (ledsIn[i].r * brightness) / 255;
        ledsOut[i].g = (ledsIn[i].g * brightness) / 255;
        ledsOut[i].b = (ledsIn[i].b * brightness) / 255;
    }
    FastLED.show();
}

void rainbow(CRGB* ledsOut, int numberOfLeds) {
    // Set all LEDs to the same color
    CRGB color = CHSV(sharedHue, 255, 200);
    for (int i = 0; i < numberOfLeds; i++) {
        ledsOut[i] = color;
    }
    FastLED.show();

    sharedCounter++;
    if (sharedCounter % 50 == 0) { 
        sharedHue++;
        if (sharedHue == 255) sharedHue = 0; // Wrap around hue
    }
}

void clearRing(CRGB* leds, int numLeds) {
    for (int i = 0; i < numLeds; i++) {
        leds[i] = CRGB::Black;
    }
    FastLED.show();
}

void onDisconnectPattern(CRGB* ledsInner, int numLedsInner, CRGB* ledsOuter, int numLedsOuter) {
    // Both rings fade from full red to off; the last step is black, so the rings
    // stay dark while disconnected
    for (int brightness = 255; brightness >= 0; brightness -= 5) {
        fill_solid(ledsInner, numLedsInner, CRGB(brightness, 0, 0));
        fill_solid(ledsOuter, numLedsOuter, CRGB(brightness, 0, 0));
        FastLED.show();
        delay(30); // Adjust for fade-out speed
    }
}

void onConnectPattern(CRGB* ledsInner, int numLedsInner, CRGB* ledsOuter, int numLedsOuter) {
    // Use the larger ring size for the ripple effect
    int maxLeds = max(numLedsInner, numLedsOuter);
    
    for (int ripple = 0; ripple < maxLeds; ripple++) {
        // Update inner ring
        for (int i = 0; i < numLedsInner; i++) {
            if (i == ripple % numLedsInner) {
                ledsInner[i] = CRGB::Green;
            } else {
                ledsInner[i].fadeToBlackBy(50);
            }
        }
        
        // Update outer ring
        for (int i = 0; i < numLedsOuter; i++) {
            if (i == ripple % numLedsOuter) {
                ledsOuter[i] = CRGB::Green;
            } else {
                ledsOuter[i].fadeToBlackBy(50);
            }
        }
        
        FastLED.show();
        delay(50); // Adjust for ripple speed
    }
}
