Olivermoberg98/LED-Coaster/Software/LED_coaster/src/patterns.h

#ifndef PATTERN_H
#define PATTERN_H
#include <FastLED.h>

#define LED_PIN_INNER     0
#define LED_PIN_OUTER     1
#define NUM_LEDS_INNER    10
#define NUM_LEDS_OUTER    20

extern CRGB colors_inner[NUM_LEDS_INNER];
extern CRGB colors_outer[NUM_LEDS_OUTER];

extern bool inner_needs_update;
extern bool outer_needs_update;

enum PatternType {
    FIXED,
    CHASER,
    PULSE,
    RAINBOW
};

PatternType stringToPatternType(const std::string& pattern);

void fixed(CRGB* ledsIn,CRGB* ledsOut, int numberOfLeds);
void pulse(CRGB* ledsIn,CRGB* ledsOut, int numberOfLeds, float pulseFrequency, float maxBrightness, float minBrightness);
void chaser(CRGB* ledsIn, CRGB* ledsOut, int numberOfLeds, int brightSpots,float rotationalFrequency, float maxBrightness, float minBrightness);
void rainbow(CRGB* ledsOut, int numberOfLeds);
void clearRing(CRGB* leds, int numLeds);
void runPattern(PatternType pattern, CRGB* ledsIn, CRGB* ledsOut, int numberOfLeds);
void updateLEDColors(int ring, int NUM_LEDS, const int colors[3]);
void updateLEDColors(int ring, int NUM_LEDS);
void onDisconnectPattern(CRGB* ledsInner, int numLedsInner, CRGB* ledsOuter, int numLedsOuter);
void onConnectPattern(CRGB* ledsInner, int numLedsInner, CRGB* ledsOuter, int numLedsOuter);

#endif
