Olivermoberg98/LED-Coaster/(commit log)

2024-05-03 Added KiCad files
    [LED_Coaster.kicad_pcb, LED_Coaster.kicad_sch]
2024-05-03 Code for controlling the LED
    [LED_Coaster.kicad_pcb]
2024-05-03 Added outer ring of LEDs
    [LED_Coaster.kicad_pcb, LED_Coaster.kicad_sch]
2024-05-03 Added inner ring of LEDs
    [LED_Coaster.kicad_pcb, LED_Coaster.kicad_sch]
2024-05-03 MCU schematic halfway done
    [LED_Coaster.kicad_pcb, LED_Coaster.kicad_sch]
2024-05-04 Placed all components
    [LED_Coaster.kicad_pcb, LED_Coaster.kicad_sch]
2024-05-04 Added traces and datasheets
    [LED_Coaster.kicad_pcb]
2024-05-04 Added a fuse
    [LED_Coaster.kicad_pcb, LED_Coaster.kicad_sch]
2024-05-04 Version 1 done
    [LED_Coaster.kicad_pcb]
2024-06-03 updated Kicad files
    [LED_Coaster.kicad_pcb, LED_Coaster.kicad_sch]
2024-11-05 Version 3 using esp32-C3
    [LED_Coaster-B_Cu.gbr, LED_Coaster-B_Mask.gbr, LED_Coaster-B_Paste.gbr, LED_Coaster-B_Silkscreen.gbr, LED_Coaster-Edge_Cuts.gbr, LED_Coaster-F_Cu.gbr, LED_Coaster-F_Mask.gbr, LED_Coaster-F_Paste.gbr]
2024-11-12 New file structure
    [LED_Coaster-B_Cu.gbr, LED_Coaster-B_Mask.gbr, LED_Coaster-B_Paste.gbr, LED_Coaster-B_Silkscreen.gbr, LED_Coaster-Edge_Cuts.gbr, LED_Coaster-F_Cu.gbr, LED_Coaster-F_Mask.gbr, LED_Coaster-F_Paste.gbr]
2024-12-08 Connect to the app via BLE GATT characteristics and change the color and mode of the LEDs
2024-12-11 Update of the rainbow function and some small fixes
    [BLEHandler.h, main.cpp, patterns.cpp, patterns.h]
2026-01-22 Make sure fixed mode consumes less power
    [main.cpp, patterns.cpp, patterns.h]
2026-01-22 Battery saving when not connected
2026-08-20 Latest and gratest PCB files from boa himself
    [LED_Coaster-B_Cu.gbr, LED_Coaster-B_Mask.gbr, LED_Coaster-B_Paste.gbr, LED_Coaster-B_Silkscreen.gbr, LED_Coaster-Edge_Cuts.gbr, LED_Coaster-F_Cu.gbr, LED_Coaster-F_Mask.gbr, LED_Coaster-F_Paste.gbr]
2026-08-21 Rework charging + power path: MCP73871, TLV75533, P-FET load switch
    Schematic-side rework of the power section. The PCB still needs
    "Update PCB from Schematic" (F8) plus placement/routing - see below.
    Root causes fixed
    - U3 (MCP73831) pin 2 V_SS sat on an isolated net shared only with R2 and
    never reached GND, so the charger never charged. The part is replaced
    outright and VSS (10, 11, EP) now ties to GND.
    - U4 (AMS1117-3.3) needs ~1.3 V dropout; on battery it fell under the
    ESP32-C3 brown-out threshold. Replaced with a 238 mV-dropout LDO.
    - LEDs and charger shared one +BATT node through a diode-OR, so LED current
    corrupted charge termination. The new charger has a real SYS power-pa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
    [LED_Coaster.kicad_sch]
2026-08-21 Restore true power-off and add battery-level sensing
    Two follow-ups to the power-path rework.
    1. SW1 is a real power switch again
    The previous commit fed the LDO from +SYS, which is unswitched, so SW1 only
    turned the LEDs off and the ESP32 stayed powered from the cell forever.
    U4's EN pin now follows +LED_PWR instead, so flipping SW1 off collapses the
    LED rail, which disables the LDO, which powers down the ESP32. Off-state
    drain is then dominated by the MCP73871's own ~30 uA quiescent current.
    The LDO *input* deliberately stays on the clean, unswitched +SYS node rather
    than moving downstream of the FET, so LED load current never modulates the
    MCU supply. R17 100k pulls +LED_PWR down to gu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
    [LED_Coaster.kicad_sch]
2026-08-22 Add PCB layout / JLCPCB ordering checklist; C20 to low-profile MLCC
    ORDERING.md is a phase-by-phase checklist from installing KiCad through to
    placing the order, with the placement, trace-width and DRC values specific to
    this board rather than generic advice. CLAUDE.md points at it.
    C20 changed from 220uF C_Elec_6.3x7.7 to 100uF 1210 MLCC:
    - the electrolytic is 7.7 mm tall, which is wrong for a coaster
    - it is polarized but was drawn on a non-polarized Device:C_Small symbol, so
    the silkscreen and pick-and-place rotation would not have shown polarity - a
    latent assembly hazard
    - an MLCC has lower ESR for the LED transients the cap is there to absorb
    Ceramics derate hard with DC bias, s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
    [LED_Coaster.kicad_sch]
2026-08-22 Fix unescaped quotes in generated power-symbol Description fields
    The schematic would not open: "Expecting '(' ... line 14729".
    The Description property on every power symbol I generated was written as
    (property "Description" "...global label with name "+5V"")
    with the inner quotes unescaped, so KiCad's parser terminated the string
    early and then found a bare atom where it expected a child form. 55 symbols
    were affected. They now read \"+5V\" as the original file's own power symbols
    already did.
    Why the earlier check missed it: the validator counted '(' and ')' characters
    to prove the file was balanced, which ignores string literals entirely, so a
    stray quote was invisible to it. Rep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
    [LED_Coaster.kicad_sch]
2026-08-22 Fix ERC errors: remove orphan GND symbols, add PWR_FLAG on +5V and GND
    Six ERC errors, from two separate causes.
    Four "pin not connected" errors: #PWR05, #PWR09, #PWR011 and #PWR016 were
    GND symbols belonging to the old power section that my deletion pass failed
    to remove, left floating with nothing attached.
    Cause: those four use the GND_1..GND_5 library symbols, whose instances carry
    a (lib_name ...) child. That pushes the (at x y rot) line from index 2 to
    index 3 of the block, and the region filter read index 2 unconditionally, so
    the position never parsed and the symbols were silently kept. 13 symbols in
    the file have this shape; 4 of them fell inside the region being cleared.
    Two "po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
    [LED_Coaster.kicad_sch]
2026-08-23 Clear ERC warnings: R17 on-grid, project library for +SYS / +LED_PWR
    ERC is now 0 errors, 67 warnings. Addressing the ones that are mine.
    R17 pulldown block was at x=512.06, which is not a multiple of the 1.27 mm
    connection grid, producing four endpoint_off_grid warnings. Moved to 511.81
    (1.27 x 403). Two annotation texts nudged onto grid as well; they carry no
    connectivity. No off-grid points remain anywhere above x=300 - the 22 that
    are left are all original LED-ring geometry.
    +SYS and +LED_PWR existed only as cached copies inside the schematic, so ERC
    reported "not found in symbol library 'power'" 21 times. They are now a real
    project library: LED_Coaster.kicad_sym plus a project sym-li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
    [LED_Coaster.kicad_sch]
2026-08-23 ORDERING.md: clarify MPN/BOM flow, correct to single-sided assembly
    The previous order was single-sided (front only, 27 parts); the WS2812Bs,
    ESP32 module and connectors were hand-soldered. Only parts carrying an MPN
    field reach the generated BOM, and ones without it are omitted silently
    rather than appearing blank - worth calling out explicitly, since six of the
    new parts currently have no MPN.
    Also moves the LED decoupling caps to the front side placed opposite their
    back-side LED, so assembly stays single-sided. Two vias through 1.6 mm is
    electrically close enough, and it avoids roughly doubling assembly cost.
2026-08-24 Set verified LCSC part numbers; correct the charger to the 4.20V variant
    The charger part number was wrong. C637761, carried over from the original
    fix spec as "MCP73871-2CCI/ML", is actually MCP73871-4CAI/ML. Per the
    datasheet's Product Identification System the leading digit selects the
    charge voltage: 2CC is 4.20V, 4CA is 4.40V. Fitting it would have regulated
    a standard 4.2V Li-Po cell to 4.40V - an overcharge, with the cell life and
    safety consequences that implies. It was also out of stock, which is what
    prompted the search that caught it.
    U3 MPN is now C5121473 = MCP73871-2CCI/ML = 4.20V, the variant the design was
    actually built around. Its CC suffix also enables LBO at 3.1V, so STA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
    [LED_Coaster.kicad_sch]
2026-08-24 Machine-place the LED ring and ESP32 module (double-sided assembly)
    D1-D30 and U1 were excluded from assembly two ways: (dnp yes) in the
    schematic, and no MPN field. Both are now cleared so JLCPCB places them.
    D1-D30 WS2812B-B/T C2761795
    U1 ESP32-C3-WROOM-02-H4 C2944070
    C2761795 is Standard-assembly only (MSL 5a), which matches the move to
    double-sided anyway since Economic is single-side only.
    J1 and J4 stay hand-soldered - both through-hole, so not SMT-placeable.
    ORDERING.md updated: assembly model, cost expectation, and a warning that
    the custom WS2812B footprint has no Fabrication Toolkit rotation rule.
    [LED_Coaster.kicad_sch]
2026-08-24 Verify WS2812B CPL rotation; order all 5 assembled
    Checked the placements against how Fabrication Toolkit builds the CPL.
    Its transformations.csv has no entry matching the project-local footprint
    LED_WS2812_5050_handsolder, so the LEDs get no automatic correction.
    The placements themselves are consistent: all 30 LEDs sit at 270 degrees
    relative to their seat on the ring - the top ring directly, the bottom
    ring in its mirrored frame after the toolkit's (180 - rot) correction.
    Spread within each ring is 0.1 degrees. Both data chains are unbroken.
    So any rotation error is one global constant, not a per-part problem, and
    the preview check reduces to inspecting one LED per side. If a correction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
2026-08-24 Verify F8 result; correct Phase 3 and rescope Phase 5
    Analysed the post-F8 board net by net.
    Phase 2 verified: footprint swaps landed, D31/D32 gone, DNP cleared on
    D1-D30 and U1 with MPNs intact, 88 parts in both schematic and PCB, and
    total copper unchanged at 413 items so no routing was lost. Corrected the
    predicted count from 19 added to the actual 23 (C8-C19 were undercounted).
    Phase 3 corrected. It said to delete the old +BATT traces feeding the
    rings; that would have been destructive. KiCad re-assigned those 104
    copper items from +BATT to +LED_PWR automatically during F8 because the
    pads they attach to changed net. Only 29 stale items actually need
    deleting, all on an empty net in x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
    [LED_Coaster.kicad_pcb]
2026-08-25 small pcb update
2026-09-01 Phase 3: delete the orphaned copper from the old power section
    The 29 netless copper items left behind by D31/D32 and the old U3/U4
    footprints are removed. Total board copper goes 413 -> 384; nothing else
    changed. +LED_PWR keeps its 104-item ring distribution, GND 92, the ring
    inputs, USB and buttons untouched, 88 footprints, antenna keepout intact.
    No netless copper remains.
    ORDERING.md corrections found while verifying readiness:
    - Phase 3 lists the exact bounding box and the 25 F.Cu / 2 via / 2 B.Cu
    breakdown, and now says to select by net rather than rubber-banding an
    area that also holds live +5V, GND and +LED_PWR copper. A new box says
    to leave the netless ESP32 antenna keepout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
    [LED_Coaster.kicad_pcb]
2026-09-02 Phase 4: place all 34 parts, and correct the outer-ring rotation analysis
    Every unplaced part now has a verified position, angle and side. Checked
    against the board file: courtyard overlap per side, through-hole pads against
    the opposite side, all four corners inside the 90 mm outline, and every pad
    against tracks of a foreign net.
    Before placing, 13 more leftovers went: 7 thin +LED_PWR feed segments from the
    old switch run and 4 GND segments plus 2 vias from the old C4/C5 connections.
    Phase 3 could not catch these because they still carried a live net. Copper is
    371 items. Three dead copper zones also went - two +3V3 and one GND, drawn
    around the old AMS1117 at (122.25, 56.58), each connec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
    [LED_Coaster.kicad_pcb]
2026-09-02 Move C10/C14 outward, and restructure Phase 5 as a numbered action list
    C10 and C14 sit in the two tightest gaps on the outer ring, so at the exact
    midpoint bearing they overlapped D7 and D17 by 0.07 mm. They were nudged 1°
    sideways, which left them visibly off-centre in the slot. Moving them outward
    to r = 35 instead puts them back on the midpoint bearing with the round
    rotations the other six use, and widens their clearance to +1.40/+0.81 mm - the
    roomiest on the ring. Outward also keeps every capacitor at or beyond the LED
    radius, so nothing encroaches on the battery pocket in the middle of the back.
    Phase 5 was hard to act on: reference material and steps were interleaved. It
    is now on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
    [LED_Coaster.kicad_pcb]
2026-09-03 Phase 5: add a trace-drawing primer and exact pads for the power path
    Action 3 said things like "U3 SYS to Q1 source to Q1 drain", which does not
    match what KiCad shows. It labels pads by number and net, so there is no pad
    called "source", and U3 has five pads on +SYS with no hint which to use.
    Action 3 now gives every connection as from-pad to to-pad with pad numbers and
    board coordinates, split into 3.1 through 3.5.
    The important one: only U3 pads 1 and 20 are the charger's actual output. Pads
    4, 9 and 17 are PROG2, TE and CE - configuration straps tied to the same net
    that carry microamps. Routing the 1.8 A load path through one of those would
    put the LED current through a signal pin.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
2026-09-03 Phase 5: spell out net-class assignment and the QFN fan-out
    Two things action 1 and action 3 left the reader to work out, both of which bite
    immediately.
    Net classes: the dialog has a class list and a net-assignment list, and filling
    in one without the other silently drops a net to Default. Action 1 now names
    which nets go in which class and warns that an unassigned net comes out at
    0.25 mm with no error - which is exactly what happens to +LED_PWR and +SYS, the
    only two nets that actually need 1.0 mm.
    QFN escape: U3 is 0.5 mm pitch with 0.25 mm pads, so a 1.0 mm trace cannot start
    on one - it laps the neighbouring pads and DRC is right to refuse. Added the
    standard fan-out: leave the pad s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
2026-09-03 Correct the back-side geometry analysis, and rescope Phase 5 accordingly
    Earlier revisions derived back-side pad coordinates by mirroring the X axis.
    KiCad does not do that, and everything built on it was wrong. Caught because
    the PCB editor showed D1 pad 4 at (180.35, 82.65) where this analysis put pad 3.
    What was wrong, and what is actually true:
    - The outer ring does not fan. Both rings are uniform - every LED sits at 90 deg
    to its own radius, spread 0.07 deg outer and 0.14 deg inner.
    - Its +LED_PWR pads are not scattered over 6.6 mm of radius. They lie on one
    clean circle at r = 30.5 mm, the way the inner ring does at r = 18.8 mm. There
    is no forced zig-zag.
    - DOUT to DIN hops ar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
2026-09-03 Add pcb_check.py, a standalone board analysis tool, and document it
    Every board question in this project so far has been answered by writing a
    throwaway parser, and several of those parsers were wrong in ways that produced
    confident bad advice. This commits one tool instead, and records the traps.
    Hardware/PCB/tools/pcb_check.py reads LED_Coaster.kicad_pcb directly - stdlib
    only, no KiCad install. Subcommands: nets, net <NAME>, shorts, rings, zones,
    widths, placement, all. KiCad DRC stays the authority on manufacturability;
    this answers what DRC does not, namely whether a net is genuinely one island
    and which pad is stranded.
    Six parsing traps are encoded in the header comment, each of whi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
    [LED_Coaster.kicad_pcb]
2026-09-05 Fix pad geometry in pcb_check.py: absolute angles and round pads
    Two bugs made the shorts check report 29 overlaps on a board that has
    none.
    A pad's stored (at x y ang) angle is absolute - KiCad has already
    folded the footprint's rotation into it. Adding the footprint rotation
    again turned every pad on a rotated part by an extra rot, which on
    this board is 71 of 88 footprints, and on a 0.5 mm pitch QFN rotates
    pads clean across their neighbours. That accounted for 17 of the
    phantom overlaps, all on U3.
    Every pad was also approximated by its bounding rectangle. On an
    8.6 mm circular M4 mounting-hole pad the corners overstate the copper
    by a factor of sqrt(2) - 1.8 mm of metal that is not th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
2026-09-05 Close the last outer-ring data hop, D13 to D14
    Five B.Cu segments detouring around C13. That completes phase 5
    action 5: the outer chain is 19 of 19 hops, and with the inner ring
    already done both data chains are continuous end to end.
    [LED_Coaster.kicad_pcb]
2026-09-05 Phase 5: spell out action 8 as five sub-steps with exact pads
    Action 8 was four lines naming nets. It now follows action 3's shape:
    five sub-steps, 17 traces, each a From/To table giving both pad
    numbers and their board coordinates, with the layer and the reason
    the width is what it is.
    Sub-steps 8.1 to 8.3 are the short front-side runs - U3's three
    configuration resistors, the P-FET gate through Q1 pad 1, and R13's
    other end onto +SYS. 8.4 and 8.5 are the long hauls and the only
    places a via is needed.
    Two measurements worth having in the file:
    - The B.Cu corridor for the STAT runs. Between U3 and R5 the outer
    LED ring's copper stops at r = 34.4 mm and J3's shield holes start
    at r =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
2026-09-13 Add a strays check for the copper DRC does not look at
    Three classes of junk survive a clean DRC run, so `strays` sweeps for
    all three and `all` now includes it.
    Board-edge clearance is the one that reaches the fab. KiCad ships
    min_copper_edge_clearance at 0.0, so the rule passes whatever you draw
    - this board carried a 1.0 mm +SYS trace 0.022 mm from the outline with
    DRC perfectly happy, and the routing bit would have eaten it. The
    sweep measures against 0.30 mm.
    The other two are dangling stubs left by a mis-started route and
    zero-length segments from the interactive router.
    The dangling sweep took three passes to get right, and each failure is
    worth recording:
    - Anchoring on "is the e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
2026-09-13 Finish phase 5: route what was left and clean the board up
    Every net with more than one pad is now one island, there are no
    shorts, both LED chains are continuous, and the strays sweep is clean.
    Routing:
    - Action 8 in full - U3's three config resistors, the P-FET gate,
    R13 onto +SYS, both status LEDs across to R5/R16/D33/D35, and the
    battery-sense divider.
    - A B.Cu link between J3's two VBUS pad pairs. They had only ever been
    joined by the priority-1 +5V zone, and when that zone shrank on a
    refill the status LEDs went with it - +5V split in two. The whole
    USB signal row sits between the pads and the F.Cu escapes below are
    taken by CC1, CC2 and the differential pairs, so the lin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
    [LED_Coaster.kicad_pcb]
2026-09-13 Phase 5: add the two checks that would have caught this round
    Action 9 gains two sub-steps, both written from things that went wrong.
    9a covers ground pads the pour does not reach, because the fix depends
    on a number that is easy to walk past. A pad sitting exactly
    thermal_gap from a large island is not a pad the pour failed to find -
    the copper is wrapped right around it and the filler simply could not
    place its spokes. That one wants Solid pad connection, with thermal
    relief put back per-pad on the through-hole parts you hand-solder. A
    pad 1-2 mm out is the other problem entirely and wants a stub.
    9b runs `pcb_check.py strays` for edge clearance, dangling stubs and
    zero-length segments,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
2026-09-13 Point Serial at the USB-C port instead of the UART header
    The core defaults ARDUINO_USB_CDC_ON_BOOT to 0, which makes Serial
    UART0 on IO20/IO21. That is the J4 header, and J4 is DNP - so every
    Serial.println in the firmware was going somewhere with no part fitted.
    Setting the flag makes Serial the USB-Serial-JTAG peripheral, reached
    through J3's D+/D- and the 22R series resistors R10/R11 into IO18/IO19,
    so flashing and logging both work over the USB-C connector alone.
    ARDUINO_USB_MODE=1 is required alongside it. HWCDC.h declares Serial
    only inside `#if ARDUINO_USB_MODE`, so CDC_ON_BOOT on its own renames
    the UART instance to Serial0 and leaves no Serial declared at all -
    the build fails wit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
2026-09-13 Fix two checks that called a fragmented board clean
    KiCad's DRC found 7 unconnected items and a clearance violation on a
    board this tool had just reported as fully connected with no shorts.
    Both were holes in the checks, not in DRC.
    connectivity() treated every fill of a zone as one node. A zone's
    filler emits disjoint islands, so a pour fragmented into a dozen
    pieces read as a single connected thing - which is precisely the
    failure the check exists to catch, and it hid eight separate GND
    groups. Each fill island is now its own node, and islands merge only
    where fills of *different* zones actually meet. Gotcha 4 already said
    this; the code did not do it.
    cmd_shorts skipped anything without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
2026-09-13 Enlarge U1's stitching vias so they clear annular and hole-to-hole
    The twelve GND vias inside the ESP32 module's land pattern were
    0.40 mm pads on a 0.30 mm drill: 0.05 mm of annular ring against a
    0.13 mm rule, and 0.478 mm hole-to-hole on the 0.778 mm diagonal
    against a 0.4995 mm rule. That is 28 of the 139 DRC violations, none
    of them from anything drawn on this board.
    They are now 0.55 mm pads on a 0.25 mm drill, which gives 0.15 mm of
    annular ring and 0.528 mm hole-to-hole. Nothing else moves: the
    nearest foreign pad is 0.978 mm away and the nearest other hole is the
    next via in the array.
    This needs Minimum through hole set to 0.20 mm, which the phase 6 note
    now spells out. U3's QFN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
    [LED_Coaster.kicad_pcb]
2026-09-13 Phase 6: DRC passes with zero errors
    Two board changes finish it off.
    J3 had a footprint-level thermal-relief override on its zone
    connections, which it should never have been given - that is for parts
    someone solders by hand, and J3 is reflow-assembled. The USB-C land
    pattern has no room for two spokes, so every affected pad came out
    starved: A9 and B4 on +5V, and the S1 shield legs on GND across both
    layers. It now inherits Solid from the zones like everything else.
    J1 and J4 keep their relief; J1 is the through-hole battery connector
    and J4 is DNP, so both really are hand-soldered.
    The +5V priority-1 zone is deleted. After the B.Cu link between J3's
    two VBUS pad pairs went in, its fill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
    [LED_Coaster.kicad_pcb]
2026-09-13 Mark J1 DNP, and correct what the guide says about exclusions
    J1 is the through-hole JST battery connector, hand-soldered by
    decision, and the guide has always listed it that way - but it was
    never actually DNP. It came out of the Fabrication Toolkit as a
    bom.csv line with an empty LCSC Part #: in the assembly list, and
    unsourceable. Setting it DNP brings the count to 83 parts, 51 front
    and 32 back, which is the number the guide already claimed.
    Set in both places, because they do different jobs: the schematic
    symbol carries (dnp yes) and the footprint carries (attr through_hole
    dnp). The schematic is the one that matters - Update PCB from
    Schematic overwrites a board-only change and puts t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
    [LED_Coaster.kicad_pcb, LED_Coaster.kicad_sch]
2026-09-13 Phase 7: regenerate production files for the reworked board
    The previous contents predated the power rework and would have
    ordered the wrong board - bom.csv listed an MCP73831 in SOT-23-5 and
    an AMS1117, neither of which exists here, across 31 parts all on top.
    Now 26 lines covering 83 parts, which is what phase 7 says to expect.
    The BOM and the CPL name exactly the same 83 designators, no line has
    an empty LCSC Part #, and none of H1, H3, H4, J1 or J4 appears in
    either. positions.csv is 51 top and 32 bottom, and every row's layer
    matches the footprint's side on the board.
    Checked rather than assumed:
    - MCP73871-2CC as C5121473, TLV75533PDBVR as C404027, AO3401A as
    C15127, WS2812B x30 a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
    [bom.csv, designators.csv, positions.csv]
2026-09-13 Drop the buttons from assembly and re-source C20
    JLCPCB had C318884 out of stock for BTN1-BTN4 and short on C296305
    for C20.
    The buttons are now DNP. The firmware reads none of them - there is
    no pinMode or digitalRead anywhere in src/ - and BTN3 and BTN4 are the
    ESP32 boot and reset buttons, which native USB-Serial-JTAG flashing
    does not need. Hand-soldering four tactile switches later is easier
    than finding a substitute that matches the land pattern, which needs
    two 1.80 x 1.10 mm pads plus two mechanical in an 8.6 x 9.3 mm
    envelope.
    C20 moves from C296305 to C380336, a 10 V 22uF X5R 0805. The 6.3 V
    alternative was cheaper but a 22uF X5R in an 0805 case loses most of
    its capacitance unde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
    [LED_Coaster.kicad_pcb, LED_Coaster.kicad_sch, bom.csv, positions.csv]
2026-09-17 Route charger status to the ESP32 and move the order to Economic
    The board reports charge state in firmware now instead of on LEDs. U3's
    three open-drain status outputs go to spare ESP32 pins - STAT1/LBO to
    IO5, STAT2 to IO6, PG to IO10 - and the status LEDs D33/D35 with their
    resistors R5/R16 are deleted.
    Deleting them is required, not cosmetic: they pulled STAT1/STAT2 up to
    +5V, and the ESP32-C3 is rated 3.6 V max on a pin. PG is what makes the
    state decodable at all - per the MCP73871 Table 5-1, charging and low
    battery share the same STAT1/STAT2 pair and differ only in PG.
    The assembly model changes with it. The order is now Economic, single
    sided, front only: 20 BOM lines and 47 place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
    [LED_Coaster.kicad_pcb, LED_Coaster.kicad_sch]
2026-09-17 Phase 6 and 7: DRC clean, production files regenerated
    20 BOM lines, 47 parts, 7 extended. C55109525 at quantity 10 for the
    inner ring; no R5/R16/D33/D35 and no back-side parts anywhere in the
    BOM. positions.csv is 47 parts, all top layer.
    pcb_check reports every multi-pad net fully connected and no strays.
    Note that the toolkit silently skipped bom.csv on the first run because
    the file was open elsewhere - the other four artifacts regenerated
    normally, so check its timestamp before trusting it.
    [bom.csv, designators.csv, positions.csv]
2026-09-19 Switch the LEDs to C26167850 and give the back-side parts thermal relief
    Every WS2812B is MSL 5a and rated 240 C peak reflow. Economic PCBA runs a
    255 C profile and does not bake, so JLCPCB rejects them at cart time no
    matter what the part page's PCBA Type field claims - that field is
    catalogue metadata, not what the ordering system enforces. C55109525,
    C5380881 and both house-brand parts all advertise "Economic and Standard"
    and all fail. Only the cart is authoritative.
    TUOZHAN TZ-5050S2RGB-5V-I4-H1 clears it: MSL 3, 250 C peak, qualified at
    260 C x 10 s twice with 0/22 failures. Verified accepted as Economic.
    It is a better part here besides. Classic 1=VDD 2=DOU 3=GND 4=DIN pinout
    so it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
    [LED_Coaster.kicad_pcb, LED_Coaster.kicad_sch, bom.csv]
2026-09-19 Clean out superseded and stale files from Hardware/PCB
    Everything removed is either regenerated by Phase 7, belongs to an earlier
    design, or never belonged in the PCB folder.
    Superseded by production/: Gerber/ and Gerber.zip, the two .pos files,
    Manufacture/ and bom/ibom.html.
    Abandoned prototypes: "LED Coaster/" targets an esp32doit-devkit driving a
    single LED on pin 5 and does not compile - there is a bare `modes =` in it.
    "Wireless communication config/" talks to an HM-10 over Serial2, which the
    ESP32-C3's built-in BLE replaced. Software/LED_coaster/ superseded both.
    Stale: the ATmega16U4/32U4 datasheet is the wrong MCU family for a C3
    design and was the largest file in the folder at 5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
    [LED_Coaster-B_Cu.gbr, LED_Coaster-B_Mask.gbr, LED_Coaster-B_Paste.gbr, LED_Coaster-B_Silkscreen.gbr, LED_Coaster-Edge_Cuts.gbr, LED_Coaster-F_Cu.gbr, LED_Coaster-F_Mask.gbr, LED_Coaster-F_Paste.gbr]
2026-10-01 Record the actual LED part in CLAUDE.md and correct the current figures
    The fitted LED is TUOZHAN TZ-5050S2RGB-5V-I4-H1 (C26167850), not a WS2812B.
    Every WS2812B is MSL 5a and rated 240 C peak, which JLCPCB's 255 C Economic
    reflow rejects; the TZ part is MSL 3 and rated 250 C. It is a drop-in -
    same pinout, GRB, 800 kbit/s, and bit timing FastLED's WS2812 driver sits
    inside - but its reset is 80 us rather than the 280 us of newer WS2812B
    revisions, and it drives 12 mA/channel rather than ~20.
    That halves the current problem without removing it. All 30 at full white
    is 1.08 A rather than 1.8 A, ~1.17 A with the ESP32 on BLE - still over the
    <1 A the MCP73871 datasheet recommends. The failure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
2026-10-08 Cap LED draw at 900 mA so a full-white frame cannot brown out the ESP32
    All 30 TZ-5050S2RGB at full white draw 1.08 A at 12 mA per channel, ~1.17 A
    with the ESP32 on BLE. The LEDs tolerate that; the rail does not. Roughly
    265 mOhm from the cell through the MCP73871's BAT->SYS path and Q1 drops
    ~306 mV, so at a 3.6 V cell +SYS reaches 3.37 V, U4 falls out of regulation
    and the ESP32 resets - a white frame mid-game would reboot the coaster.
    900 mA holds +SYS at 3.40 V down to a 3.6 V cell and costs ~17% of peak
    white. Harmless with only the 10-LED inner ring fitted (0.36 A), needed
    before the outer ring goes on.
    [main.cpp]
2026-10-10 Read battery voltage and charger state, and record the verified charge path
    The firmware logs the cell voltage (GPIO4 divider), an estimated percentage
    and the MCP73871 PG/STAT1/STAT2 state over USB serial every 2 s. CLAUDE.md
    records the battery and charger bring-up from 2026-10-08 and the first full
    charge curve.
2026-10-10 Publish battery status to the app over BLE (Package 3)
    A READ | NOTIFY characteristic on the coaster service carries a 13-byte
    status packet: voltage, percent, charger state, flags, raw status pins and
    uptime, with the same sum checksum as Packages 1 and 2. It is pushed on
    subscribe, every 30 s and on a debounced charger-state change. The standard
    Battery Service (0x180F) carries the same percent for generic tools, and the
    battery-fake environment cycles every state for app testing. CLAUDE.md
    specifies the packet under "The BLE contract".
2026-10-10 Add app guide and Stage A refactor plan for the Android app
2026-10-10 Move the BLE packet encoders and UUIDs into a protocol package
    Packets.encodePackage1/2, Pattern and Rgb replace the four copies of the
    encoders and the two copies of the UUIDs in MainActivity and
    CoasterDevice. Golden-byte tests freeze the exact bytes for every
    pattern, both ring flags and edge colours, and check that Pattern
    matches the mode dropdown. The transport is unchanged.
2026-10-10 Route GameActivity's coasters through a shared Nordic BLE connection layer
    CoasterConnection wraps a Nordic BleManager per coaster. Its request
    queue serialises every write, and connection state is exposed as a
    StateFlow. The app-scoped CoasterRepository in CoasterApp hands out one
    connection per MAC address. CoasterDevice, its duplicate GATT callback
    and its permission prompt are removed.
    A failed connect now shows a toast and frees the circle. A game only
    starts once every assigned coaster is ready. MainActivity still owns
    its own GATT until B3.
    [CoasterConnection.kt]
2026-10-10 Keep advertising at a slow interval instead of stopping after 2 minutes
    The app reconnects to known coasters by address, which fails while a coaster
    is not advertising. After the 2-minute fast phase the coaster now restarts
    advertising at 2.0-2.2 s and keeps going until a central connects. The
    advertising data is set once in begin(), and NimBLE's own advertise-on-
    disconnect is off so BLEHandler owns every restart.
    [BLEHandler.cpp, BLEHandler.h]
2026-10-10 Move MainActivity onto the shared connections and scan for coasters over BLE
    - CoasterScanner runs a BLE scan filtered on the coaster service UUID,
    replacing classic discovery and its broadcast receiver.
    - SavedDevicesStore keys saved coasters by address. A missing name
    falls back to the address instead of deleting the entry.
    - Permissions go through one Activity Result request for SCAN and
    CONNECT. The manifest drops location, BLUETOOTH and BLUETOOTH_ADMIN.
    - No createBond: the firmware needs no security.
    - Toasts report the coaster's own GATT state, not any ACL link. The
    light and effect controls stay locked until a coaster is ready.
    - GameActivity lists every saved coaster with it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
    [CoasterConnection.kt]
2026-10-10 Hold screen state in MainViewModel and GameViewModel
    MainViewModel owns the scan, saved devices, current coaster and its
    connect/disconnect messages. GameViewModel owns the circle count and
    circle assignments. Both survive configuration changes, so the
    manifest's configChanges workaround is gone. Circles are rebuilt only
    when the count changes and re-bound in place when assignments change.
    Scan results use a ListAdapter. Leaving the app (MainViewModel cleared)
    disconnects every coaster.
    [GameViewModel.kt, MainViewModel.kt]
2026-10-10 Run games as cancellable coroutines in GameViewModel
    NattDuellen and RandomDrink are suspend functions over CoasterController,
    which CoasterConnection implements. Each colour write suspends until the
    coaster acknowledges it, replacing the hand-tuned 100 ms gaps. The game
    plays on a snapshot of the circles and is cancelled as a whole when a
    coaster is removed, replaced or dropped by a smaller circle count, so it
    can neither half-run nor crash on an empty set. Games survive rotation.
    Dropping onto an occupied circle replaces and disconnects the coaster
    there. The drag shadow comes from the pressed row, and a failed drop
    redraws the circles instead of clearing occupied ones.
    Virtual-time test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
    [CoasterConnection.kt, GameViewModel.kt]
2026-10-10 Rename the app to com.olivermoberg.ledcoaster and split the UI packages
    applicationId and namespace both become com.olivermoberg.ledcoaster, so
    this installs as a new app beside the old one. The screens move to
    ui.main and ui.game. rootProject.name becomes LedCoaster and the theme
    Theme.LedCoaster. The lint baseline is re-recorded because the two
    Overdraw entries quote the theme name.
2026-10-10 Mark Stage B done in the refactor plan
2026-10-10 Decode Package 3 battery status in the protocol package
    BatteryStatusDecoder checks type, version, length and checksum in that
    order and returns Ok(BatteryStatus) or Rejected(reason, detail). A
    charger code outside 0-6 decodes as UNKNOWN, keeping the voltage. Percent
    0xFF or above 100 decodes as null. Raw flags and pins are kept for the
    run-down logger. Tests cover the documented example reading, high-bit
    u16/u32 values, every charger state, flags, and each rejection reason.
2026-10-10 Subscribe to battery status and expose it per connection
    CoasterBleManager looks up the status characteristic as optional, then
    in initialize() enables notifications before a single read. Both feed
    CoasterConnection.batteryStatus, a StateFlow that is null until the
    first valid packet and again after a disconnect. Decoded packets are
    logged at INFO and rejected ones at WARN with the reason.
    connect() now rethrows CancellationException instead of reporting a
    cancelled connect as a failure.
    [CoasterConnection.kt]
2026-10-10 Pin FastLED and NimBLE to the versions verified on the board
    The ^3.8.0 range let a new build environment fetch FastLED 3.10.6, which
    lights every LED white on this board regardless of the frame sent. Pinning
    FastLED 3.10.3 and NimBLE-Arduino 1.4.3 makes every environment build the
    same, verified libraries.
2026-10-10 Move MainActivity to Jetpack Compose
    MainScreen replaces the XML layouts and BluetoothDeviceAdapter; selections
    live in MainViewModel. Adds the Compose BOM 2026.06.01 and lifecycle 2.10.0,
    the newest that build on AGP 8.13.
    [MainScreen.kt, MainViewModel.kt]
2026-10-10 Move GameActivity to Jetpack Compose
    GameScreen replaces the XML layouts and DevicesAdapter. Coasters are
    dragged onto circles with Compose drag-and-drop, carrying the address as
    clip data; circles are laid out by circleRows as before. Section and
    Dropdown are shared from MainScreen. The lint baseline drops the 16
    entries the removed layouts fixed.
    [GameScreen.kt, MainScreen.kt]
2026-10-10 Show coaster battery status on both screens
    The main screen shows a status line for the current coaster and each game
    circle shows its coaster's percent, charging mark and a red tint when low.
    Status older than 90 s is greyed, checked against a 1 s monotonic ticker.
    CoasterConnection.lowBatteryWarnings raises a Snackbar once per low spell
    and connection, on whichever screen is visible.
2026-10-10 Replace the JitPack colour wheel with a Compose dialog
    ColorPickerDialog is a hue/saturation wheel with a brightness slider. It sends the colour when a finger lifts, one packet per drag. Dropping QuadFlask removes JitPack from the build.
    [MainScreen.kt]
2026-10-11 Fit the battery percentage to a measured run-down of the cell
    A rundown build logs one sample a minute to LittleFS under a constant
    inner-ring load and stops itself at 3.2 V. The first overnight run (6.3 h,
    no resets) replaces the generic Li-Po table in batteryPercent() with one
    fitted to this cell, 0% at 3.30 V, and moves LOW_BATTERY_WARN_MV to 3580 mV,
    about 15% or 55 minutes at that load. CLAUDE.md records the run and how to
    repeat it.
2026-10-11 Keep the run-down tools and the first run's data in the repo
    rundown_dump.py pulls the log off the coaster into tools/rundown/runs/, and
    rundown_fit.py fits a batteryPercent() table and plots the run with earlier
    runs overlaid, so changes in the cell show up over time. The 2026-10-10 run
    and its plot are the first entry.
2026-10-11 Stop on an empty cell and dim the LEDs as the battery sags
    Below 3300 mV (0% on the fitted curve) for three readings on battery, the
    coaster pushes a last status, turns the LEDs off and deep-sleeps instead of
    draining the cell into its protection circuit. Below a 3.60 V cell the LED
    current cap falls linearly from 900 mA to 300 mA at 3.40 V, so the
    BAT->SYS sag cannot pull the LDO out of regulation. The run-down and fake
    builds keep their own behaviour.
2026-10-11 Show the charger state on D34
    D34 on GPIO7 is the board's only charge indicator: on while charging, a 1 s
    blink at charge complete, a 5 Hz blink on a temperature fault or no battery,
    and off on battery. It follows the same debounced charger state as Package 3.
2026-10-11 Stop tracking stray JetBrains .idea files
    The root .idea is an empty project created by opening the repo root in
    the IDE, and Software/LED_coaster/.idea was already gitignored.
2026-10-11 Pin the Gradle daemon to Java 17
    Gradle 8.14.4 cannot run on JDK 25, which Android Studio 2026.2 bundles.
2026-10-11 Bring both CLAUDE.md guides in line with the code
    Packet length and colour validation, strtol parsing, the current log
    strings and line links in the root guide; the adb path, the dependency
    list and the Gradle daemon JDK pin in the app guide.
2026-10-16 Add the 3D-printed enclosure
    STEP from the Fusion design plus print-ready STL/3MF for the top shell
    and bottom piece, and a CLAUDE.md section on fit, print settings and
    sealing the slits against condensation.
2026-10-22 Fade the rings fully off on disconnect and tidy the firmware
    The disconnect animation applied fadeToBlackBy(5) 52 times, which only takes
    full red down to about 77/255. Nothing rendered after it, so a disconnected
    coaster kept glowing dim red until the next connection - about 35 mA from
    the cell with only the inner ring fitted. The loop now fades linearly using
    its brightness variable and ends on black.
    Also: the Package 2 log went through std::cout, which prints on UART0 (the
    unfitted J4 header) rather than USB, so it now uses Serial; the unused
    stopAdvertising() and package1Received are gone; the rainbow hue state moves
    out of the header, where every translation unit got its own copy; and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
2026-10-22 Add GitHub Actions CI for firmware, app and board
    Three jobs on every push to main and every pull request: build all three
    PlatformIO environments, run the app's assembleDebug, test and lint, and run
    pcb_check.py all against the board file.
    For that, pcb_check.py now exits 1 when nets, shorts or strays find a
    problem, and platformio.ini pins espressif32@6.12.0 (Arduino core 2.0.17,
    the one verified on the board) so a new platform release cannot change what
    CI builds.
2026-10-22 Drop the template tests and make the app's lint deterministic
    ExampleUnitTest (2 + 2 = 4) and ExampleInstrumentedTest were Android Studio
    scaffolding; the instrumented test's runner and its two androidTest
    dependencies go with them.
    The lint baseline's version entries pointed into the LED-Coaster-app
    worktree, so they matched nowhere else and showed up as warnings again.
    Versions are pinned deliberately, and "a newer version is available" changes
    with every upstream release, so GradleDependency and
    AndroidGradlePluginVersion are disabled and their entries removed. lint now
    reports no new issues against 6 baselined ones, on any machine.
    gradlew is now executable in the index, so it runs on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
2026-10-22 Remove stale and generated files from the repository
    - Two datasheets for parts this board does not use: a Wurth 0805 LED and the
    MXCHIP EMB1082 BLE module from the HM-10 era.
    - DRC.rpt, which goes stale with every board edit; the current DRC and ERC
    status is in Hardware/PCB/README.md.
    - Per-user editor state: the KiCad .kicad_prl, Software/App/.idea and the
    firmware's .vscode/settings.json.
    - PlatformIO's template READMEs in the empty include/, lib/ and test/.
    The .gitignore files now cover all of these, plus KiCad backups and reports.
2026-10-22 License the whole repository under MIT
    The MIT license moves from Hardware/PCB/ to the root, so it covers the
    firmware, the app and the enclosure as well as the board.
2026-10-22 Write the READMEs for publishing and retire ORDERING.md
    ORDERING.md was the step-by-step checklist for the layout rework and the
    first JLCPCB order, both done. What stays useful from it moves into
    Hardware/PCB/README.md: the board's pin map and charger strapping, the rules
    for changing the design, why the LED is a TZ-5050S2RGB and the SK6812 trap,
    the -2CC charger variant, how DNP works, DRC constraints, current DRC/ERC
    status, and how to hand-solder the outer ring.
    The root README now describes the project for someone landing on GitHub:
    what it is, how app and coaster talk, how to build each part, how to use it,
    status, safety and license.
    CLAUDE.md fixes: the 900 mA LED cap is in FastLED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
2026-11-07 Report a realistic battery percentage while charging
    While the charger is charging, look the discharge curve up 100 mV lower and
    cap it at 99%; report 100% only at charge complete. The charge current through
    the ~0.24 Ohm path to the cell lifts the reading about that far, so the plain
    curve read up to 28 points high and showed 100% about 35 minutes early.
    Document the 2026-11-07 charge from empty: preconditioning and recovery of an
    over-discharged cell, the ~420 mA real charge current, a capacity estimate,
    and the constant-voltage phase as a reference that settles the firmware's
    voltage accuracy. Add charging and storage advice to the README.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
